mbouyer/domotique/README.md

# domotique
gestion du chauffage et aération d'une habitation
