mbouyer/domotique/hardware/CAD/support-controle.FCStd

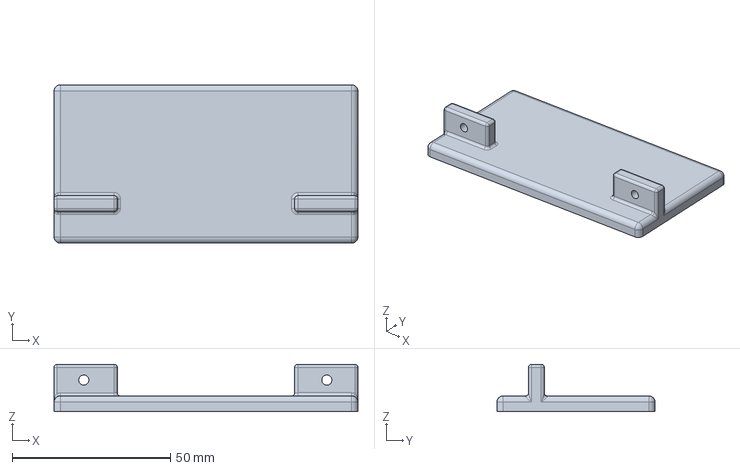
[picture p1: CAD file, 2026-06-16]
hardware/CAD/support-controle.FCStd
96.0 x 50.0 x 15.0 mm
