mbouyer/domotique/hardware/energie/CAD/1597DIN6MDH53.dxf

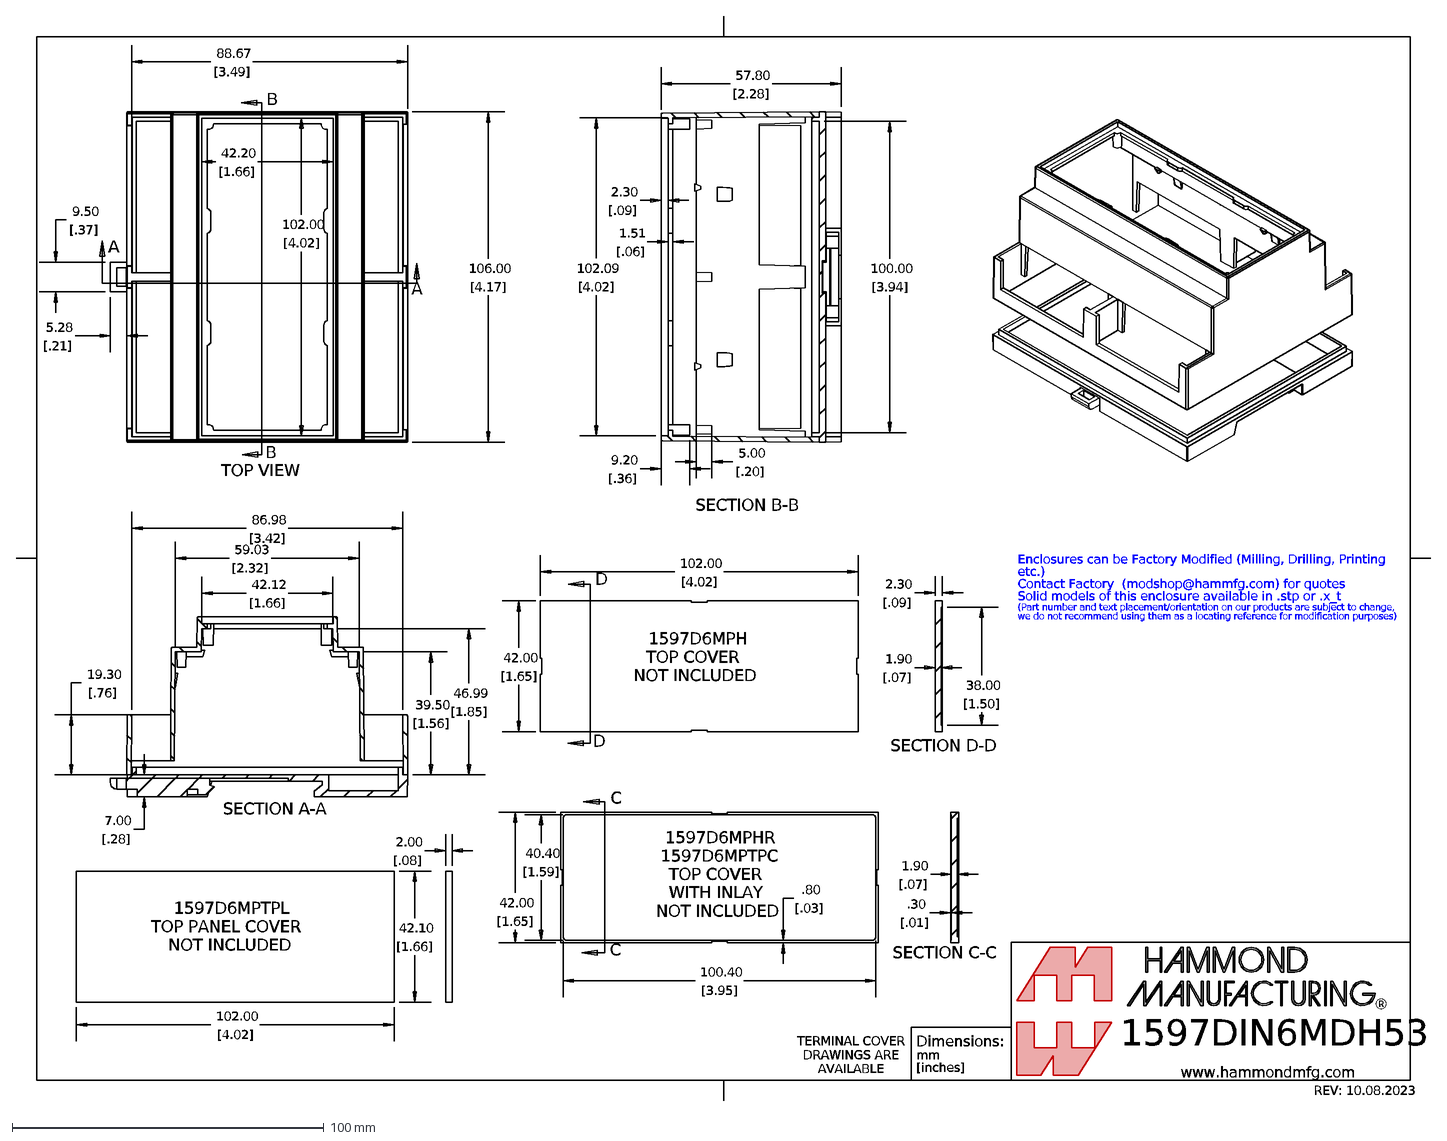
[picture p2: CAD file, 2024-11-22]
hardware/energie/CAD/1597DIN6MDH53.dxf
1597DIN6MDH53
REV: 10.08.2023
Dimensions: mm [inches]
www.hammondmfg.com
Enclosures can be Factory Modified (Milling, Drilling, Printing etc.) Contact Factory (modshop@hammfg.com) for quotes Solid models of this enclosure available i
®
TOP VIEW
A
SECTION A-A
B
SECTION B-B
1597D6MPH
TOP COVER
NOT INCLUDED
1597D6MPHR
1597D6MPTPC
WITH INLAY
102.00
[4.02]
42.00
[1.65]
40.40
[1.59]
100.40
[3.95]
C
SECTION C-C
.30
[.01]
D
SECTION D-D
1.90
[.07]
38.00
[1.50]
2.30
[.09]
.80
[.03]
9.50
[.37]
42.12
[1.66]
59.03
[2.32]
86.98
[3.42]
39.50
[1.56]
19.30
[.76]
88.67
[3.49]
57.80
[2.28]
106.00
[4.17]
42.20
1.51
[.06]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
