mbouyer/domotique/hardware/support-SEN0331/base.stl

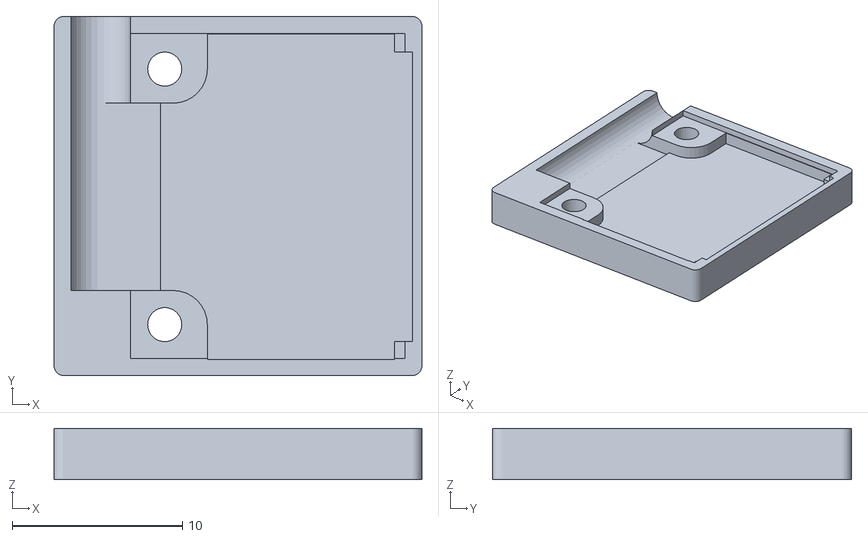
[picture p3: CAD file, 2025-10-03]
hardware/support-SEN0331/base.stl
21.6 x 21.1 x 3.00
