mbouyer/domotique/hardware/ventil/CAD/trappes.dxf

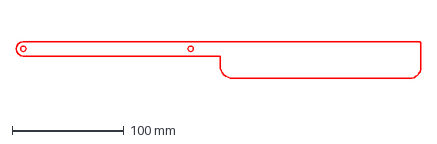
[picture p4: CAD file, 2025-04-16]
hardware/ventil/CAD/trappes.dxf
363.0 x 33.0 mm
