mbouyer/domotique/hardware/CAD/support-SEN0385.stl

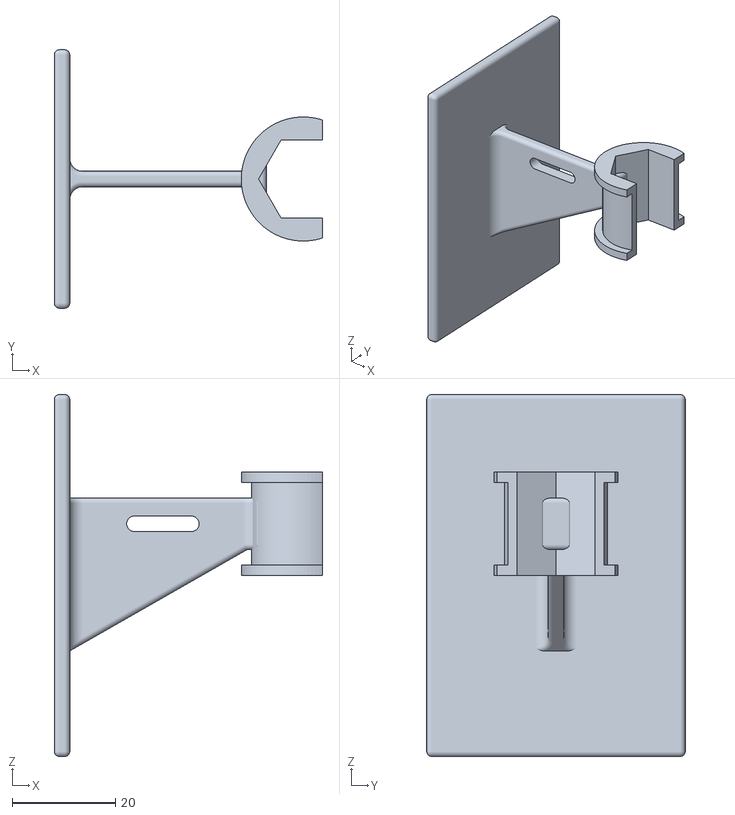
[picture p5: CAD file, 2025-04-15]
hardware/CAD/support-SEN0385.stl
51.9 x 50.0 x 70.0
