mbouyer/domotique/hardware/support-SEN0331/box.stl

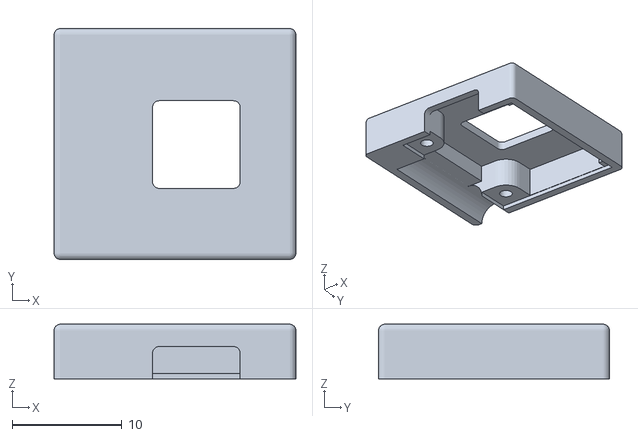
[picture p6: CAD file, 2025-10-03]
hardware/support-SEN0331/box.stl
22.1 x 21.1 x 5.00
