mbouyer/domotique/hardware/ventil/CAD/reglage.dxf

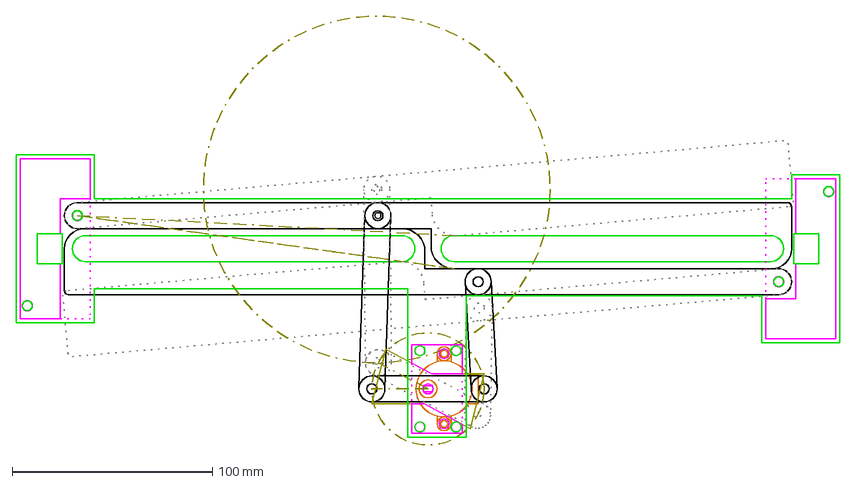
[picture p7: CAD file, 2025-04-16]
hardware/ventil/CAD/reglage.dxf
411.0 x 214.0 mm
