mbouyer/domotique/hardware/support-SEN0331/board.dxf

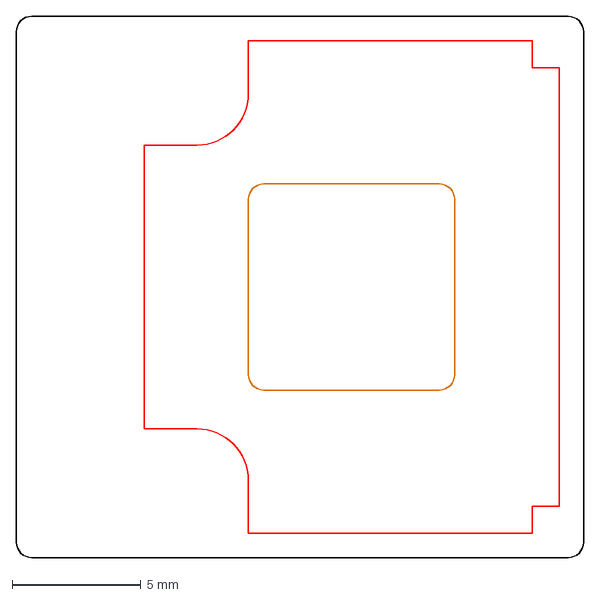
[picture p8: CAD file, 2025-10-03]
hardware/support-SEN0331/board.dxf
22.0 x 21.0 mm
