mbouyer/domotique/hardware/ventil/CAD/gabari.dxf

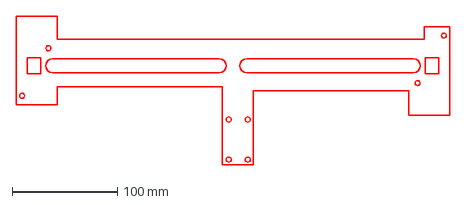
[picture p9: CAD file, 2025-04-16]
hardware/ventil/CAD/gabari.dxf
411.0 x 141.0 mm
