mbouyer/domotique/hardware/ventil/CAD/bielle-2.dxf

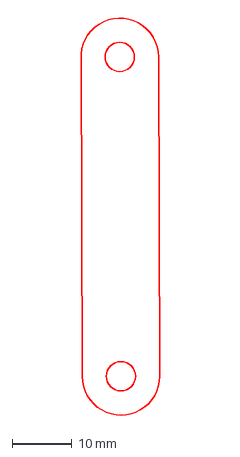
[picture p10: CAD file, 2025-04-16]
hardware/ventil/CAD/bielle-2.dxf
13.3 x 67.2 mm
