mbouyer/domotique/hardware/ventil/CAD/bielle-1.dxf

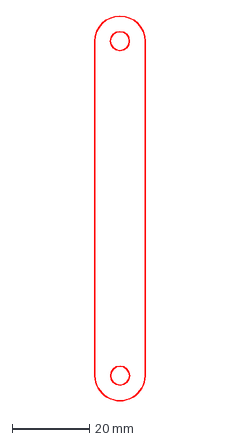
[picture p11: CAD file, 2025-04-16]
hardware/ventil/CAD/bielle-1.dxf
13.0 x 99.8 mm
