mbouyer/domotique/hardware/ventil/CAD/bielles.dxf

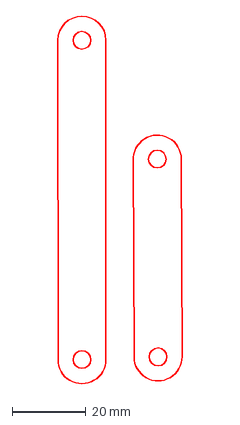
[picture p12: CAD file, 2025-04-15]
hardware/ventil/CAD/bielles.dxf
33.6 x 99.8 mm
