mbouyer/domotique/hardware/ventil/CAD/levier.dxf

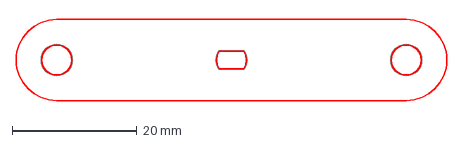
[picture p13: CAD file, 2025-04-15]
hardware/ventil/CAD/levier.dxf
69.0 x 13.0 mm
