mbouyer/domotique/hardware/ventil/CAD/passage_bielles.dxf

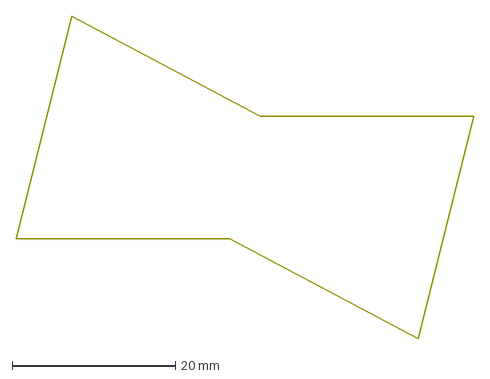
[picture p14: CAD file, 2025-04-11]
hardware/ventil/CAD/passage_bielles.dxf
56.0 x 39.5 mm
