mbouyer/domotique/hardware/support-SEN0331/params.scad

x_board=16.1;
y_board=19.1;
z_board=1;
d_cable=3.5;
ep_box=1;

x_box=x_board+d_cable+ep_box*2;
y_box=y_board+ep_box*2;
z_box=8;
z_cover=5;
z_base=z_box-z_cover;
