mbouyer/domotique/(list of files, cad)

Other CAD files:
hardware/ventil/CAD/axes_tete.scad
hardware/CAD/support-controle.dxf
