mbouyer/domotique/hardware/controle/controle.kicad_pcb

## KiCad design hardware/controle/controle.kicad_pcb (2026-06-11)

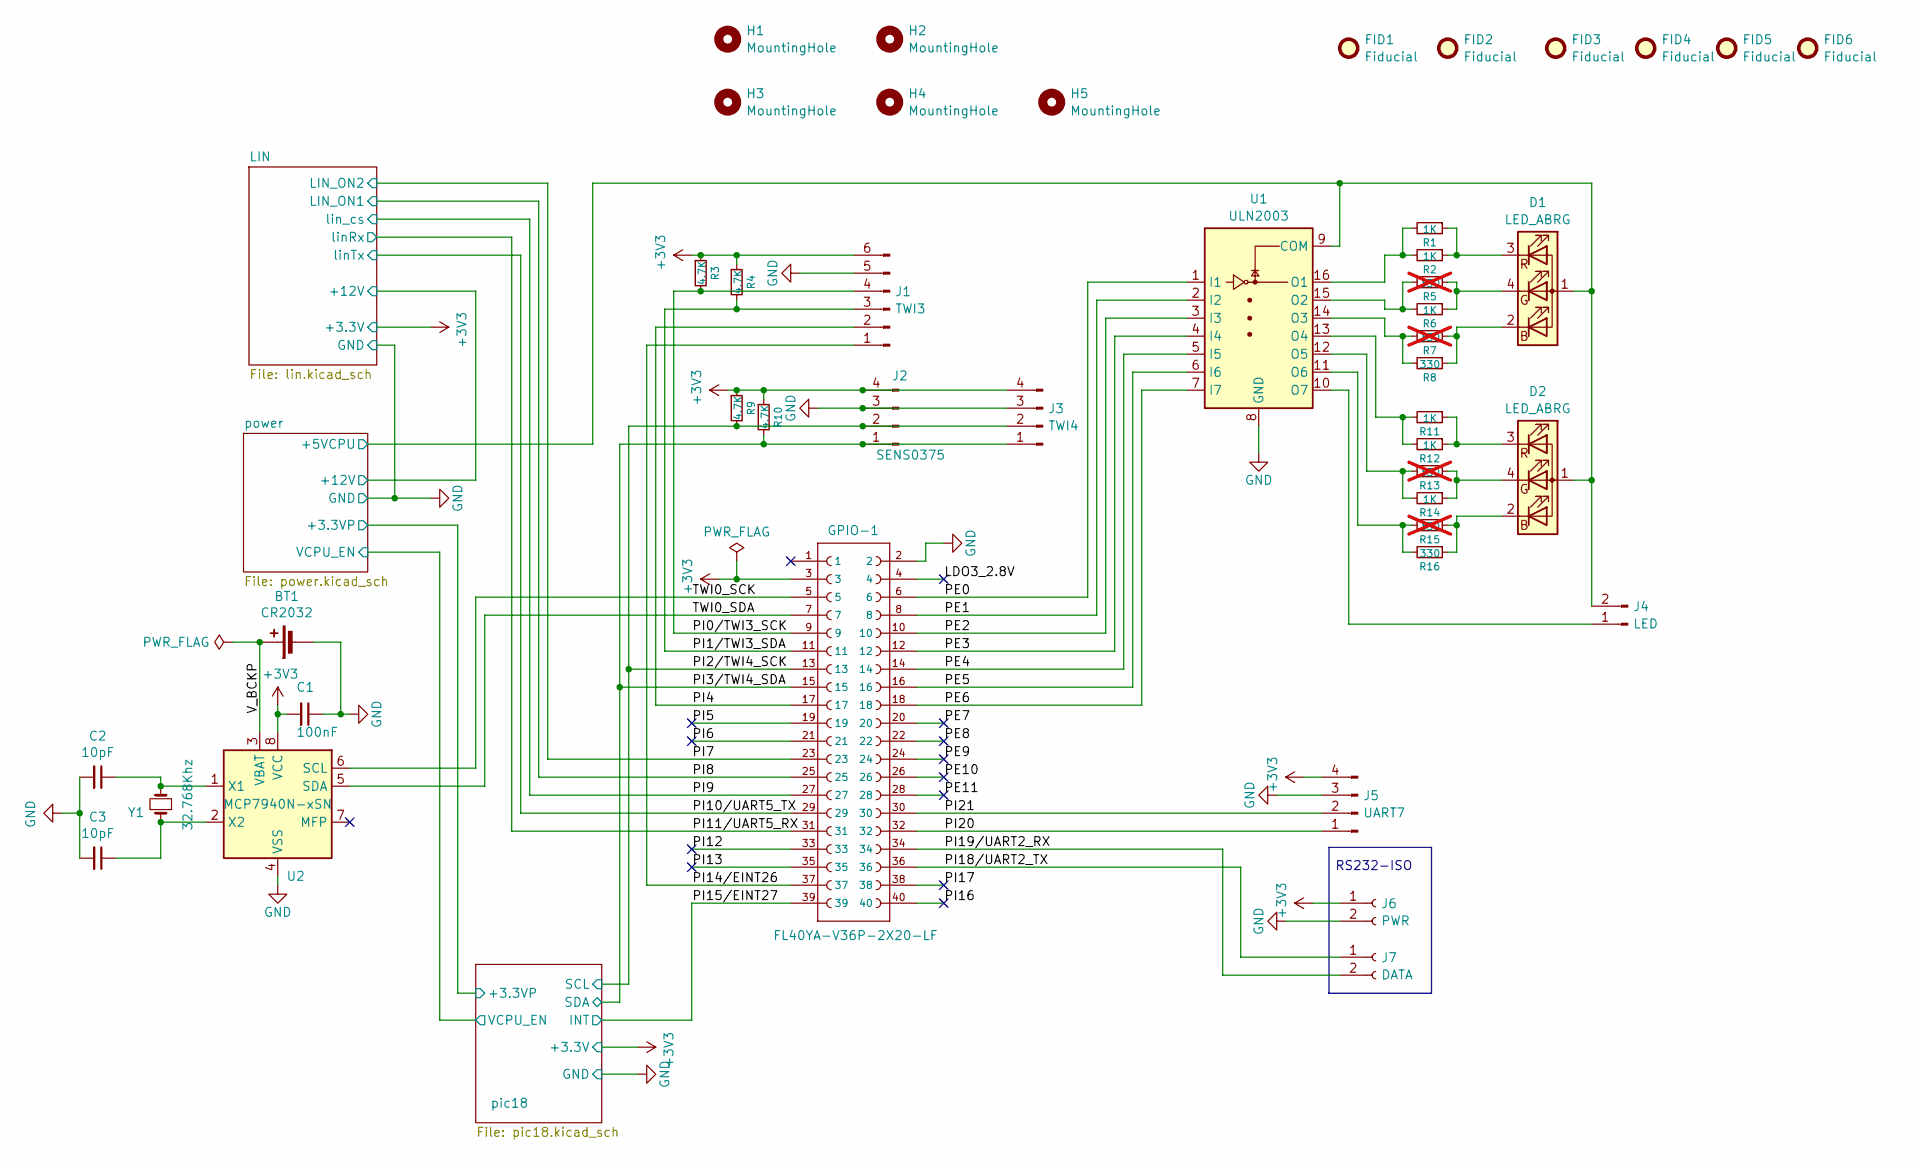
[picture p15: schematic controle.kicad_sch]

Parts:
BT1: CR2032; 1066
C1: 100nF; C_0603_1608Metric_Pad1.08x0.95mm_HandSolder
C2, C3: 10pF; C_0603_1608Metric_Pad1.08x0.95mm_HandSolder
D1, D2: LED_ABRG; LED MP001251
FID1, FID2, FID3, FID4, FID5, FID6: Fiducial; Fiducial_1mm_Mask2mm
GPIO-1: FL40YA-V36P-2X20-LF; A10_OLIMEXINO_LIME_SHIELD_1-YA-V36P-2X20-LF
H1, H2, H3, H4, H5: MountingHole; MountingHole_3.2mm_M3
J1: TWI3; PinHeader_1x06_P2.54mm_Vertical
J2: SENS0375; PinHeader_1x04_P2.54mm_Vertical
J3: TWI4; PinHeader_1x04_P2.54mm_Vertical
J4: LED; PinHeader_1x02_P2.54mm_Vertical
J5: UART7; PinHeader_1x04_P2.54mm_Vertical
J6: PWR; PinSocket_1x02_P2.54mm_Vertical
J7: DATA; PinSocket_1x02_P2.54mm_Vertical
R1, R2, R6, R11, R12, R14: 1K; R_0805_2012Metric_Pad1.20x1.40mm_HandSolder
R3, R4, R9, R10: 4.7K; R_0805_2012Metric_Pad1.20x1.40mm_HandSolder
R5, R7, R13, R15: 330; R_0805_2012Metric_Pad1.20x1.40mm_HandSolder; not fitted
R8, R16: 330; R_0805_2012Metric_Pad1.20x1.40mm_HandSolder
U1: ULN2003; SOIC-16_3.9x9.9mm_P1.27mm
U2: MCP7940N-xSN; SOIC-8_3.9x4.9mm_P1.27mm
Y1: 32.768Khz; CMR200T

Connections:
+3V3: C1.2, GPIO-1.3, J1.6, J2.4, J3.4, J5.4, J6.1, R3.1, R4.1, R9.1, R10.1, U2.8 (VCC); also elsewhere on the board
/LDO3_2.8V: GPIO-1.4
/PE0: GPIO-1.6, U1.1 (I1)
/PE1: GPIO-1.8, U1.2 (I2)
/PE2: GPIO-1.10, U1.3 (I3)
/PE3: GPIO-1.12, U1.4 (I4)
/PE4: GPIO-1.14, U1.5 (I5)
/PE5: GPIO-1.16, U1.6 (I6)
/PE6: GPIO-1.18, U1.7 (I7)
/PE7: GPIO-1.20
/PE8: GPIO-1.22
/PE9: GPIO-1.24
/PE10: GPIO-1.26
/PE11: GPIO-1.28
/PI0/TWI3_SCK: GPIO-1.9, J1.4, R3.2
/PI1/TWI3_SDA: GPIO-1.11, J1.3, R4.2
/PI2/TWI4_SCK: GPIO-1.13, J2.2, J3.2, R9.2; also elsewhere on the board
/PI3/TWI4_SDA: GPIO-1.15, J2.1, J3.1, R10.2; also elsewhere on the board
/PI4: GPIO-1.17, J1.2
/PI5: GPIO-1.19
/PI6: GPIO-1.21
/PI7: GPIO-1.23; also elsewhere on the board
/PI8: GPIO-1.25; also elsewhere on the board
/PI9: GPIO-1.27; also elsewhere on the board
/PI10/UART5_TX: GPIO-1.29; also elsewhere on the board
/PI11/UART5_RX: GPIO-1.31; also elsewhere on the board
/PI12: GPIO-1.33
/PI13: GPIO-1.35
/PI14/EINT26: GPIO-1.37, J1.1
/PI15/EINT27: GPIO-1.39; also elsewhere on the board
/PI16: GPIO-1.40
/PI17: GPIO-1.38
/PI18/UART2_TX: GPIO-1.36, J7.1
/PI19/UART2_RX: GPIO-1.34, J7.2
/PI20: GPIO-1.32, J5.1
/PI21: GPIO-1.30, J5.2
/TWI0_SCK: GPIO-1.5, U2.6 (SCL)
/TWI0_SDA: GPIO-1.7, U2.5 (SDA)
/V_BCKP: BT1.1 (+), U2.3 (VBAT)
/power/+5VCPU: D1.1 (A), D2.1 (A), J4.2, U1.9 (COM); also elsewhere on the board
GND: BT1.2 (-), C1.1, C2.2, C3.2, GPIO-1.2, J1.5, J2.3, J3.3, J5.3, J6.2, U1.8 (GND), U2.4 (VSS); also elsewhere on the board
unnamed: D1.2 (BK), R7.1, R8.1
unnamed: D1.4 (GK), R5.1, R6.1
unnamed: D1.3 (RK), R1.1, R2.1
unnamed: D2.2 (BK), R15.1, R16.1
unnamed: D2.4 (GK), R13.1, R14.1
unnamed: D2.3 (RK), R11.1, R12.1
unnamed: J4.1, U1.10 (O7)
unnamed: R1.2, R2.2, U1.16 (O1)
unnamed: R5.2, R6.2, U1.15 (O2)
unnamed: R7.2, R8.2, U1.14 (O3)
unnamed: R11.2, R12.2, U1.13 (O4)
unnamed: R13.2, R14.2, U1.12 (O5)
unnamed: R15.2, R16.2, U1.11 (O6)
unnamed: C2.1, U2.1 (X1), Y1.2
unnamed: C3.1, U2.2 (X2), Y1.1

Notes on the sheet:
RS232-ISO

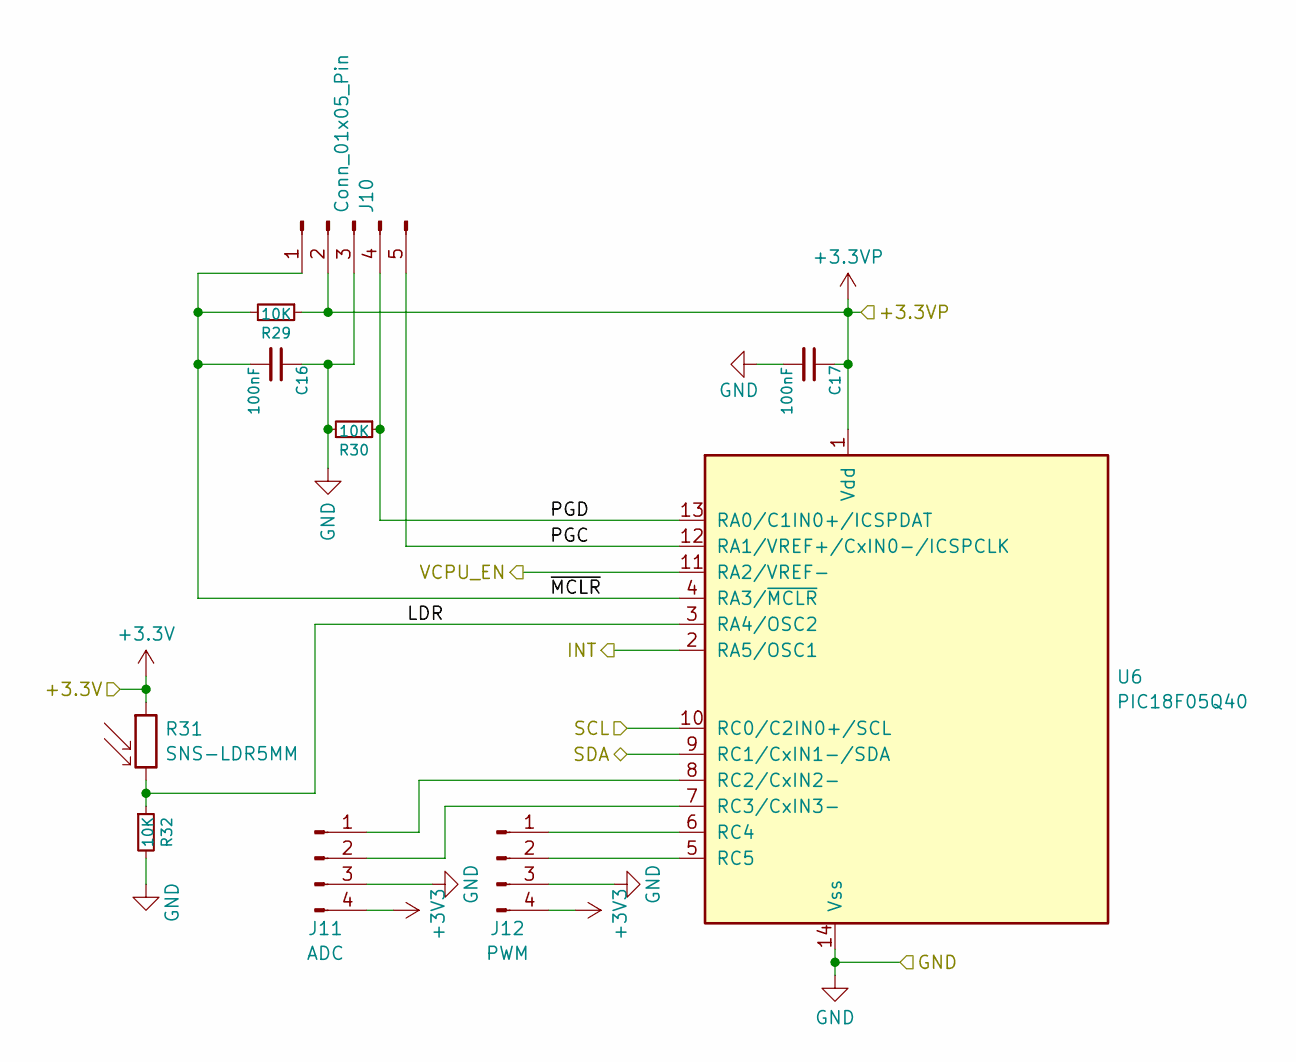
[picture p16: schematic pic18.kicad_sch]

Parts:
C16, C17: 100nF; C_0603_1608Metric_Pad1.08x0.95mm_HandSolder
J10: Conn_01x05_Pin; PinHeader_1x05_P2.54mm_Horizontal
J11: ADC; PinHeader_1x04_P2.54mm_Vertical
J12: PWM; PinHeader_1x04_P2.54mm_Vertical
R29, R30, R32: 10K; R_0805_2012Metric_Pad1.20x1.40mm_HandSolder
R31: SNS-LDR5MM; R_LDR_5.0x4.1mm_P3mm_Vertical
U6: PIC18F05Q40; SOIC-14_3.9x8.7mm_P1.27mm

Connections:
+3.3VP: C17.1, J10.2, R29.1, U6.1 (Vdd); also elsewhere on the board
+3V3: J11.4, J12.4, R31.1; also elsewhere on the board
/PI2/TWI4_SCK: U6.10 (RC0/C2IN0+/SCL); also elsewhere on the board
/PI3/TWI4_SDA: U6.9 (RC1/CxIN1-/SDA); also elsewhere on the board
/PI15/EINT27: U6.2 (RA5/OSC1); also elsewhere on the board
/pic18/LDR: R31.2, R32.1, U6.3 (RA4/OSC2)
/pic18/PGC: J10.5, U6.12 (RA1/VREF+/CxIN0-/ICSPCLK)
/pic18/PGD: J10.4, R30.1, U6.13 (RA0/C1IN0+/ICSPDAT)
/pic18/VCPU_EN: U6.11 (RA2/VREF-); also elsewhere on the board
/pic18/~MCLR: C16.2, J10.1, R29.2, U6.4 (RA3/~MCLR)
GND: C16.1, C17.2, J10.3, J11.3, J12.3, R30.2, R32.2, U6.14 (Vss); also elsewhere on the board
unnamed: J11.1, U6.8 (RC2/CxIN2-)
unnamed: J11.2, U6.7 (RC3/CxIN3-)
unnamed: J12.1, U6.6 (RC4)
unnamed: J12.2, U6.5 (RC5)

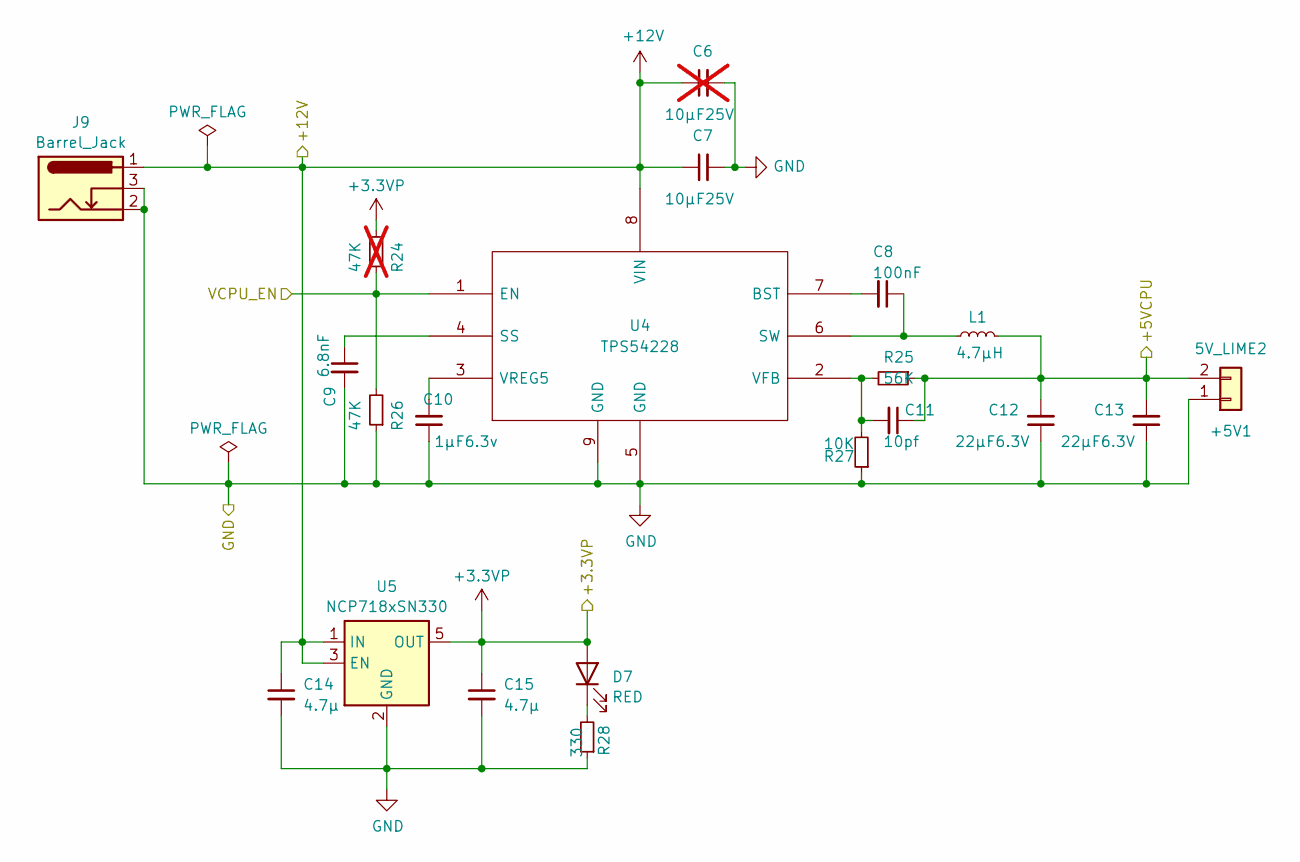
[picture p17: schematic power.kicad_sch]

Parts:
+5V1: 5V_LIME2; MC24356
C6: 10µF25V; C_1210_3225Metric_Pad1.33x2.70mm_HandSolder; not fitted
C7: 10µF25V; C_1210_3225Metric_Pad1.33x2.70mm_HandSolder
C8: 100nF; C_0603_1608Metric_Pad1.08x0.95mm_HandSolder
C9: 6.8nF; C_0603_1608Metric_Pad1.08x0.95mm_HandSolder
C10: 1µF6.3v; C_0603_1608Metric_Pad1.08x0.95mm_HandSolder
C11: 10pf; C_0603_1608Metric_Pad1.08x0.95mm_HandSolder
C12, C13: 22µF6.3V; C_1210_3225Metric_Pad1.33x2.70mm_HandSolder
C14, C15: 4.7µ; C_0805_2012Metric_Pad1.18x1.45mm_HandSolder
D7: RED; LED_0805_2012Metric
J9: Barrel_Jack; BarrelJack_Wuerth_6941xx301002
L1: 4.7µH; L_TT_7.3x6.8
R24: 47K; R_0805_2012Metric_Pad1.20x1.40mm_HandSolder; not fitted
R25: 56K; R_0805_2012Metric_Pad1.20x1.40mm_HandSolder
R26: 47K; R_0805_2012Metric_Pad1.20x1.40mm_HandSolder
R27: 10K; R_0805_2012Metric_Pad1.20x1.40mm_HandSolder
R28: 330; R_0805_2012Metric_Pad1.20x1.40mm_HandSolder
U4: TPS54228; SOIC-8-1EP_3.9x4.9mm_P1.27mm_EP2.41x3.3mm
U5: NCP718xSN330; SOT-23-5

Connections:
+3.3VP: C15.1, D7.2 (A), R24.2, U5.5 (OUT); also elsewhere on the board
+12V: C6.1, C7.1, C14.1, J9.1, U4.8 (VIN), U5.1 (IN), U5.3 (EN); also elsewhere on the board
/pic18/VCPU_EN: R24.1, R26.2, U4.1 (EN); also elsewhere on the board
/power/+5VCPU: +5V1.2, C11.1, C12.2, C13.2, L1.2, R25.1; also elsewhere on the board
GND: +5V1.1, C6.2, C7.2, C9.2, C10.1, C12.1, C13.1, C14.2, C15.2, J9.2, J9.3, R26.1, R27.1, R28.1, U4.5 (GND), U4.9 (GND), U5.2 (GND); also elsewhere on the board
unnamed: D7.1 (K), R28.2
unnamed: C8.2, U4.7 (BST)
unnamed: C9.1, U4.4 (SS)
unnamed: C8.1, L1.1, U4.6 (SW)
unnamed: C11.2, R25.2, R27.2, U4.2 (VFB)
unnamed: C10.2, U4.3 (VREG5)

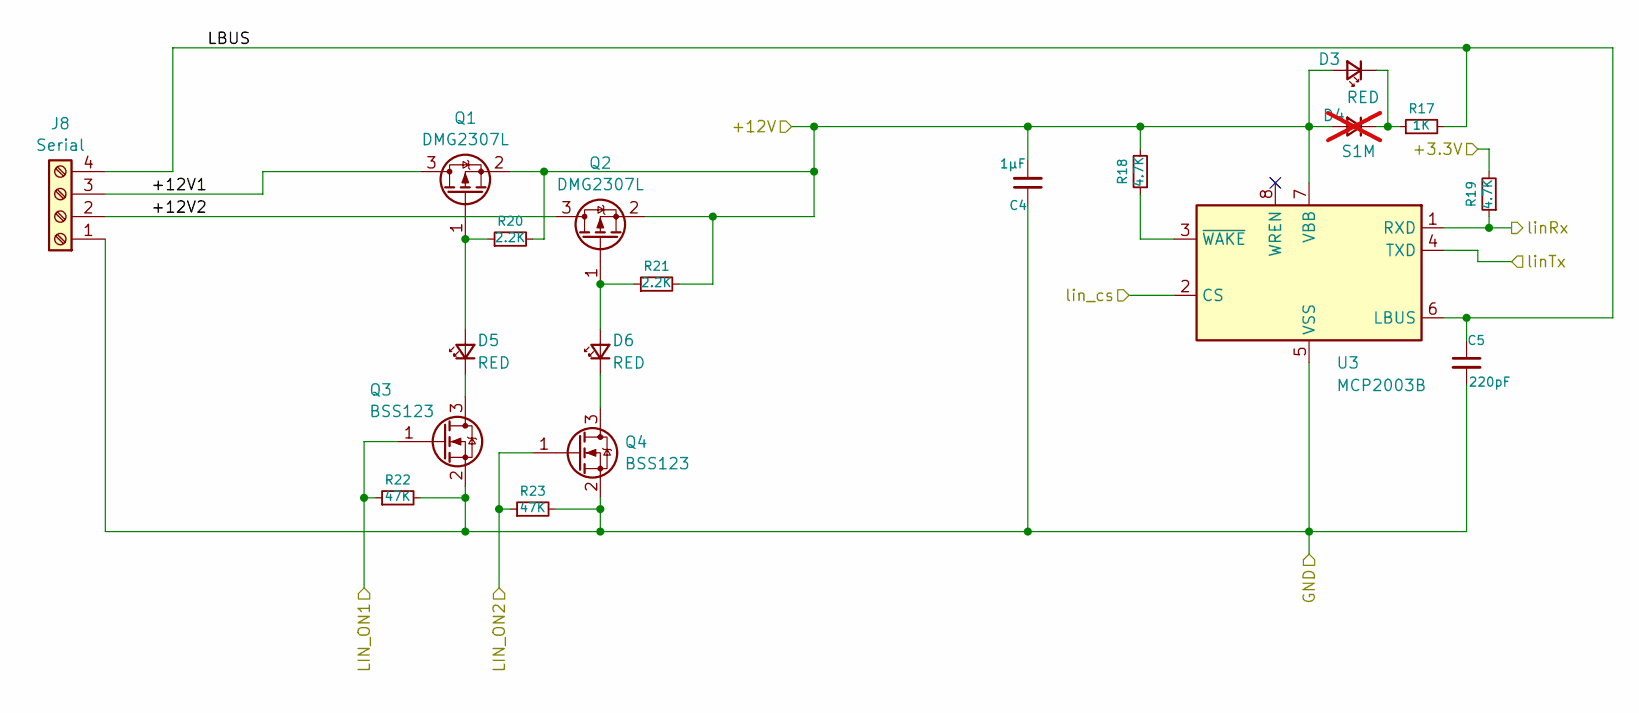
[picture p18: schematic lin.kicad_sch]

Parts:
C4: 1µF; C_0805_2012Metric_Pad1.18x1.45mm_HandSolder
C5: 220pF; C_0603_1608Metric_Pad1.08x0.95mm_HandSolder
D3, D5, D6: RED; LED_0603_1608Metric_Pad1.05x0.95mm_HandSolder
D4: S1M; D_SMA; not fitted
J8: Serial; PhoenixContact_MCV_1,5_4-G-3.5_1x04_P3.50mm_Vertical
Q1, Q2: DMG2307L; SOT-23
Q3, Q4: BSS123; SOT-23
R17: 1K; R_0805_2012Metric_Pad1.20x1.40mm_HandSolder
R18, R19: 4.7K; R_0805_2012Metric_Pad1.20x1.40mm_HandSolder
R20, R21: 2.2K; R_0805_2012Metric_Pad1.20x1.40mm_HandSolder
R22, R23: 47K; R_0805_2012Metric_Pad1.20x1.40mm_HandSolder
U3: MCP2003B; SOIC-8_3.9x4.9mm_P1.27mm

Connections:
+3V3: R19.2; also elsewhere on the board
+12V: C4.2, D3.2 (A), D4.2 (A), Q1.2 (S), Q2.2 (S), R18.2, R20.2, R21.2, U3.7 (VBB); also elsewhere on the board
/LIN/+12V1: J8.3, Q1.3 (D)
/LIN/+12V2: J8.2, Q2.3 (D)
/LIN/LBUS: C5.1, J8.4, R17.2, U3.6 (LBUS)
/PI7: Q4.1 (G), R23.1; also elsewhere on the board
/PI8: Q3.1 (G), R22.1; also elsewhere on the board
/PI9: U3.2 (CS); also elsewhere on the board
/PI10/UART5_TX: U3.4 (TXD); also elsewhere on the board
/PI11/UART5_RX: R19.1, U3.1 (RXD); also elsewhere on the board
GND: C4.1, C5.2, J8.1, Q3.2 (S), Q4.2 (S), R22.2, R23.2, U3.5 (VSS); also elsewhere on the board
unnamed: D3.1 (K), D4.1 (K), R17.1
unnamed: D5.2 (A), Q1.1 (G), R20.1
unnamed: D5.1 (K), Q3.3 (D)
unnamed: D6.2 (A), Q2.1 (G), R21.1
unnamed: D6.1 (K), Q4.3 (D)
unnamed: R18.1, U3.3 (~WAKE)

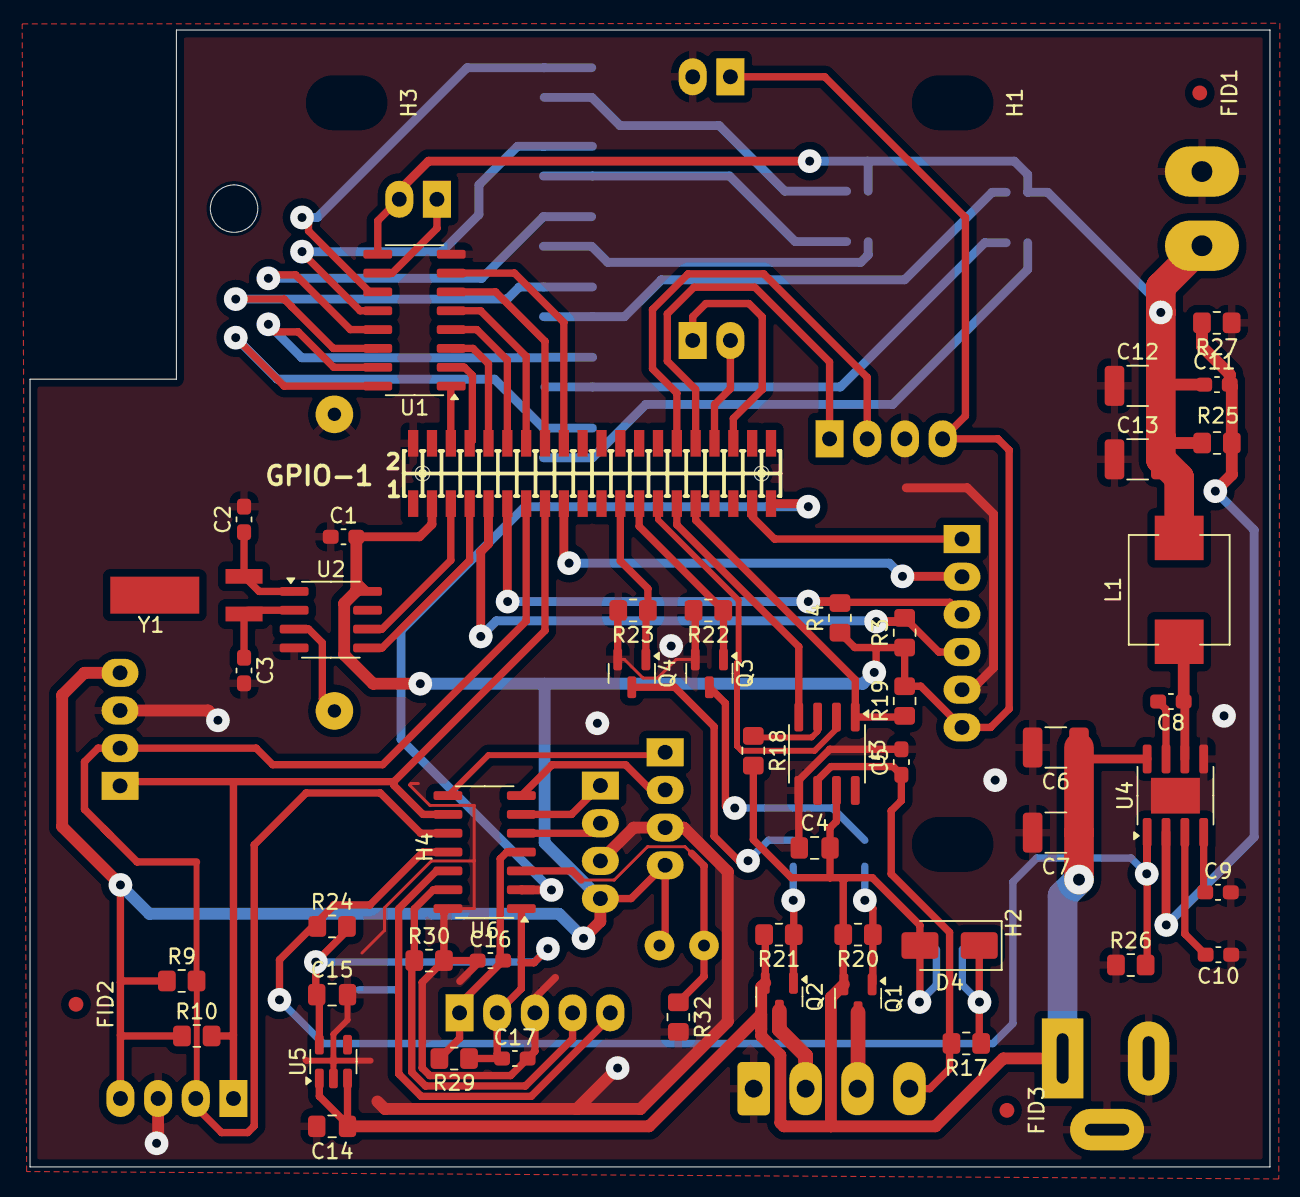
[picture p19: board controle.kicad_pcb from above]

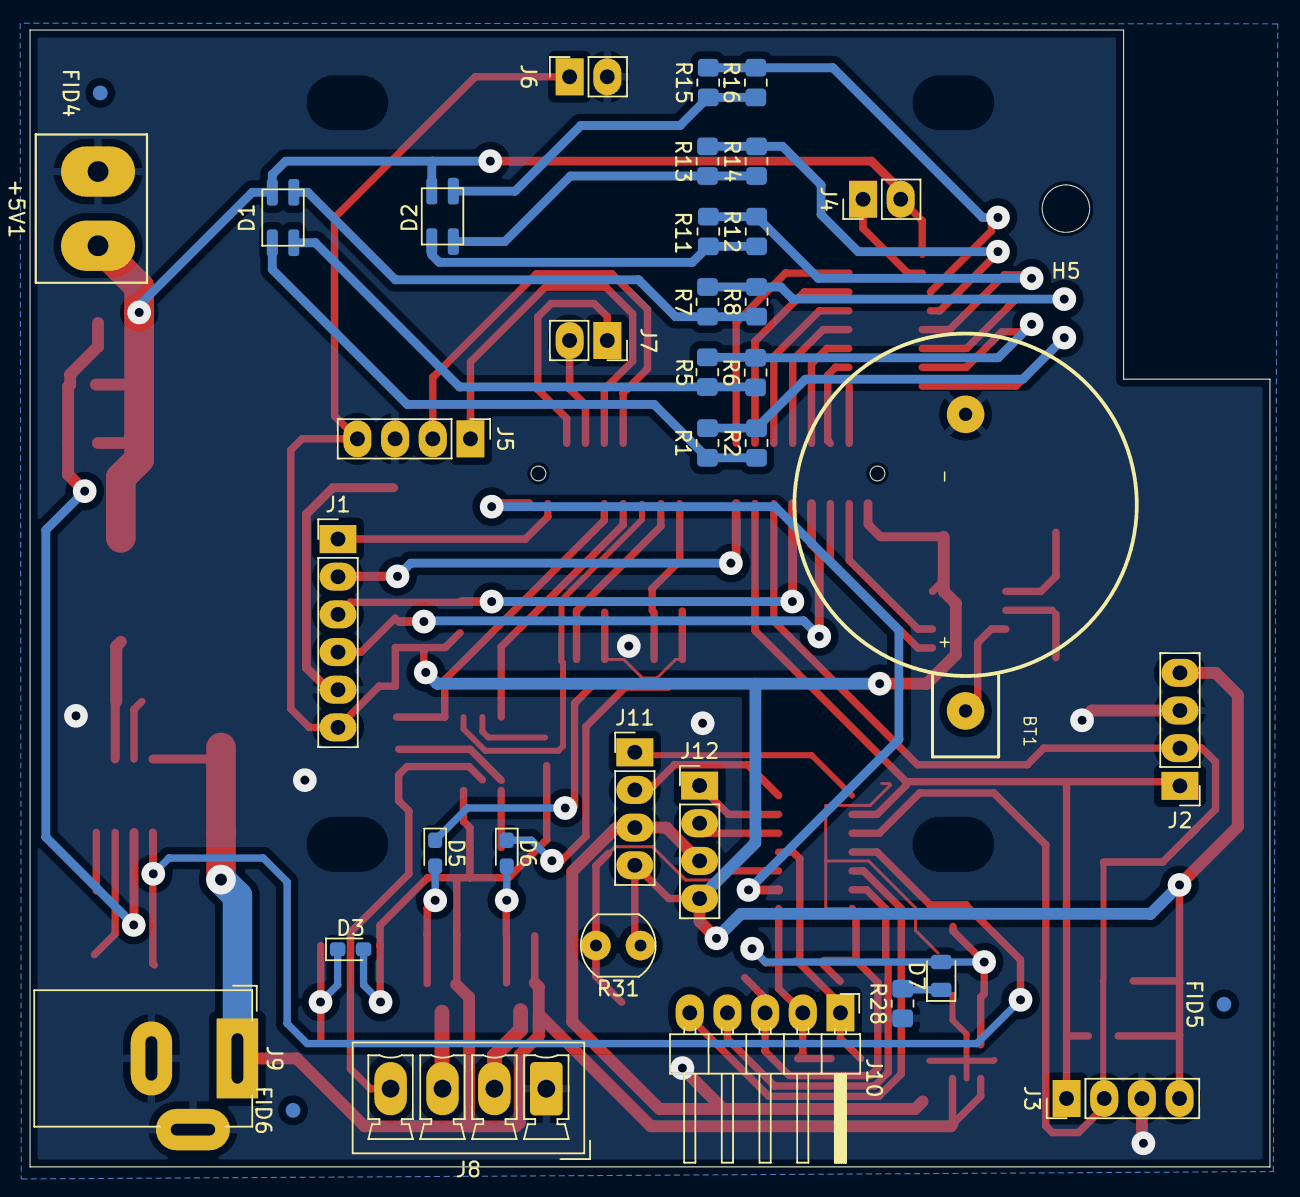
[picture p20: board controle.kicad_pcb from below]

Board: 2 copper layers, 83.6 x 76.7 mm, 94 parts (38 on the bottom side), 70 nets.
