mbouyer/domotique/hardware/sht31-break/sht31-break.kicad_pcb

## KiCad design hardware/sht31-break/sht31-break.kicad_pcb (2025-05-09)

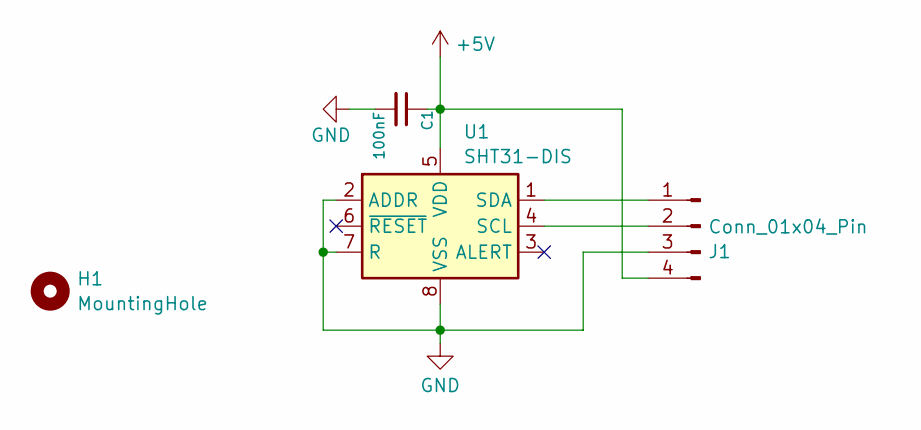
[picture p21: schematic sht31-break.kicad_sch]

Parts:
C1: 100nF; C_0603_1608Metric_Pad1.08x0.95mm_HandSolder
H1: MountingHole; MountingHole_3.2mm_M3
J1: Conn_01x04_Pin; SolderWire-0.1sqmm_1x04_P3.6mm_D0.4mm_OD1mm_Relief
U1: SHT31-DIS; Sensirion_DFN-8-1EP_2.5x2.5mm_P0.5mm_EP1.1x1.7mm

Connections:
+5V: C1.1, J1.4, U1.5 (VDD)
GND: C1.2, J1.3, U1.2 (ADDR), U1.7 (R), U1.8 (VSS), U1.9 (VSS)
unnamed: J1.1, U1.1 (SDA)
unnamed: J1.2, U1.4 (SCL)

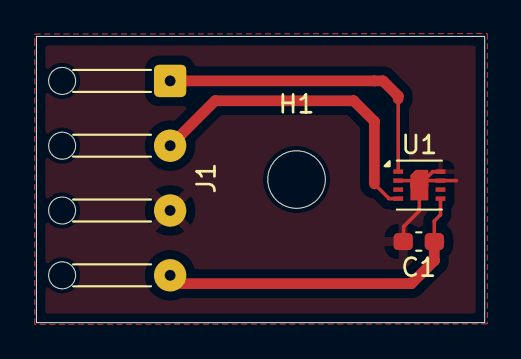
[picture p22: board sht31-break.kicad_pcb from above]

Board: 2 copper layers, 24.9 x 15.9 mm, 4 parts (0 on the bottom side), 4 nets.
