mbouyer/domotique/hardware/ventil/ventil.kicad_pcb

## KiCad design hardware/ventil/ventil.kicad_pcb (2025-04-18)

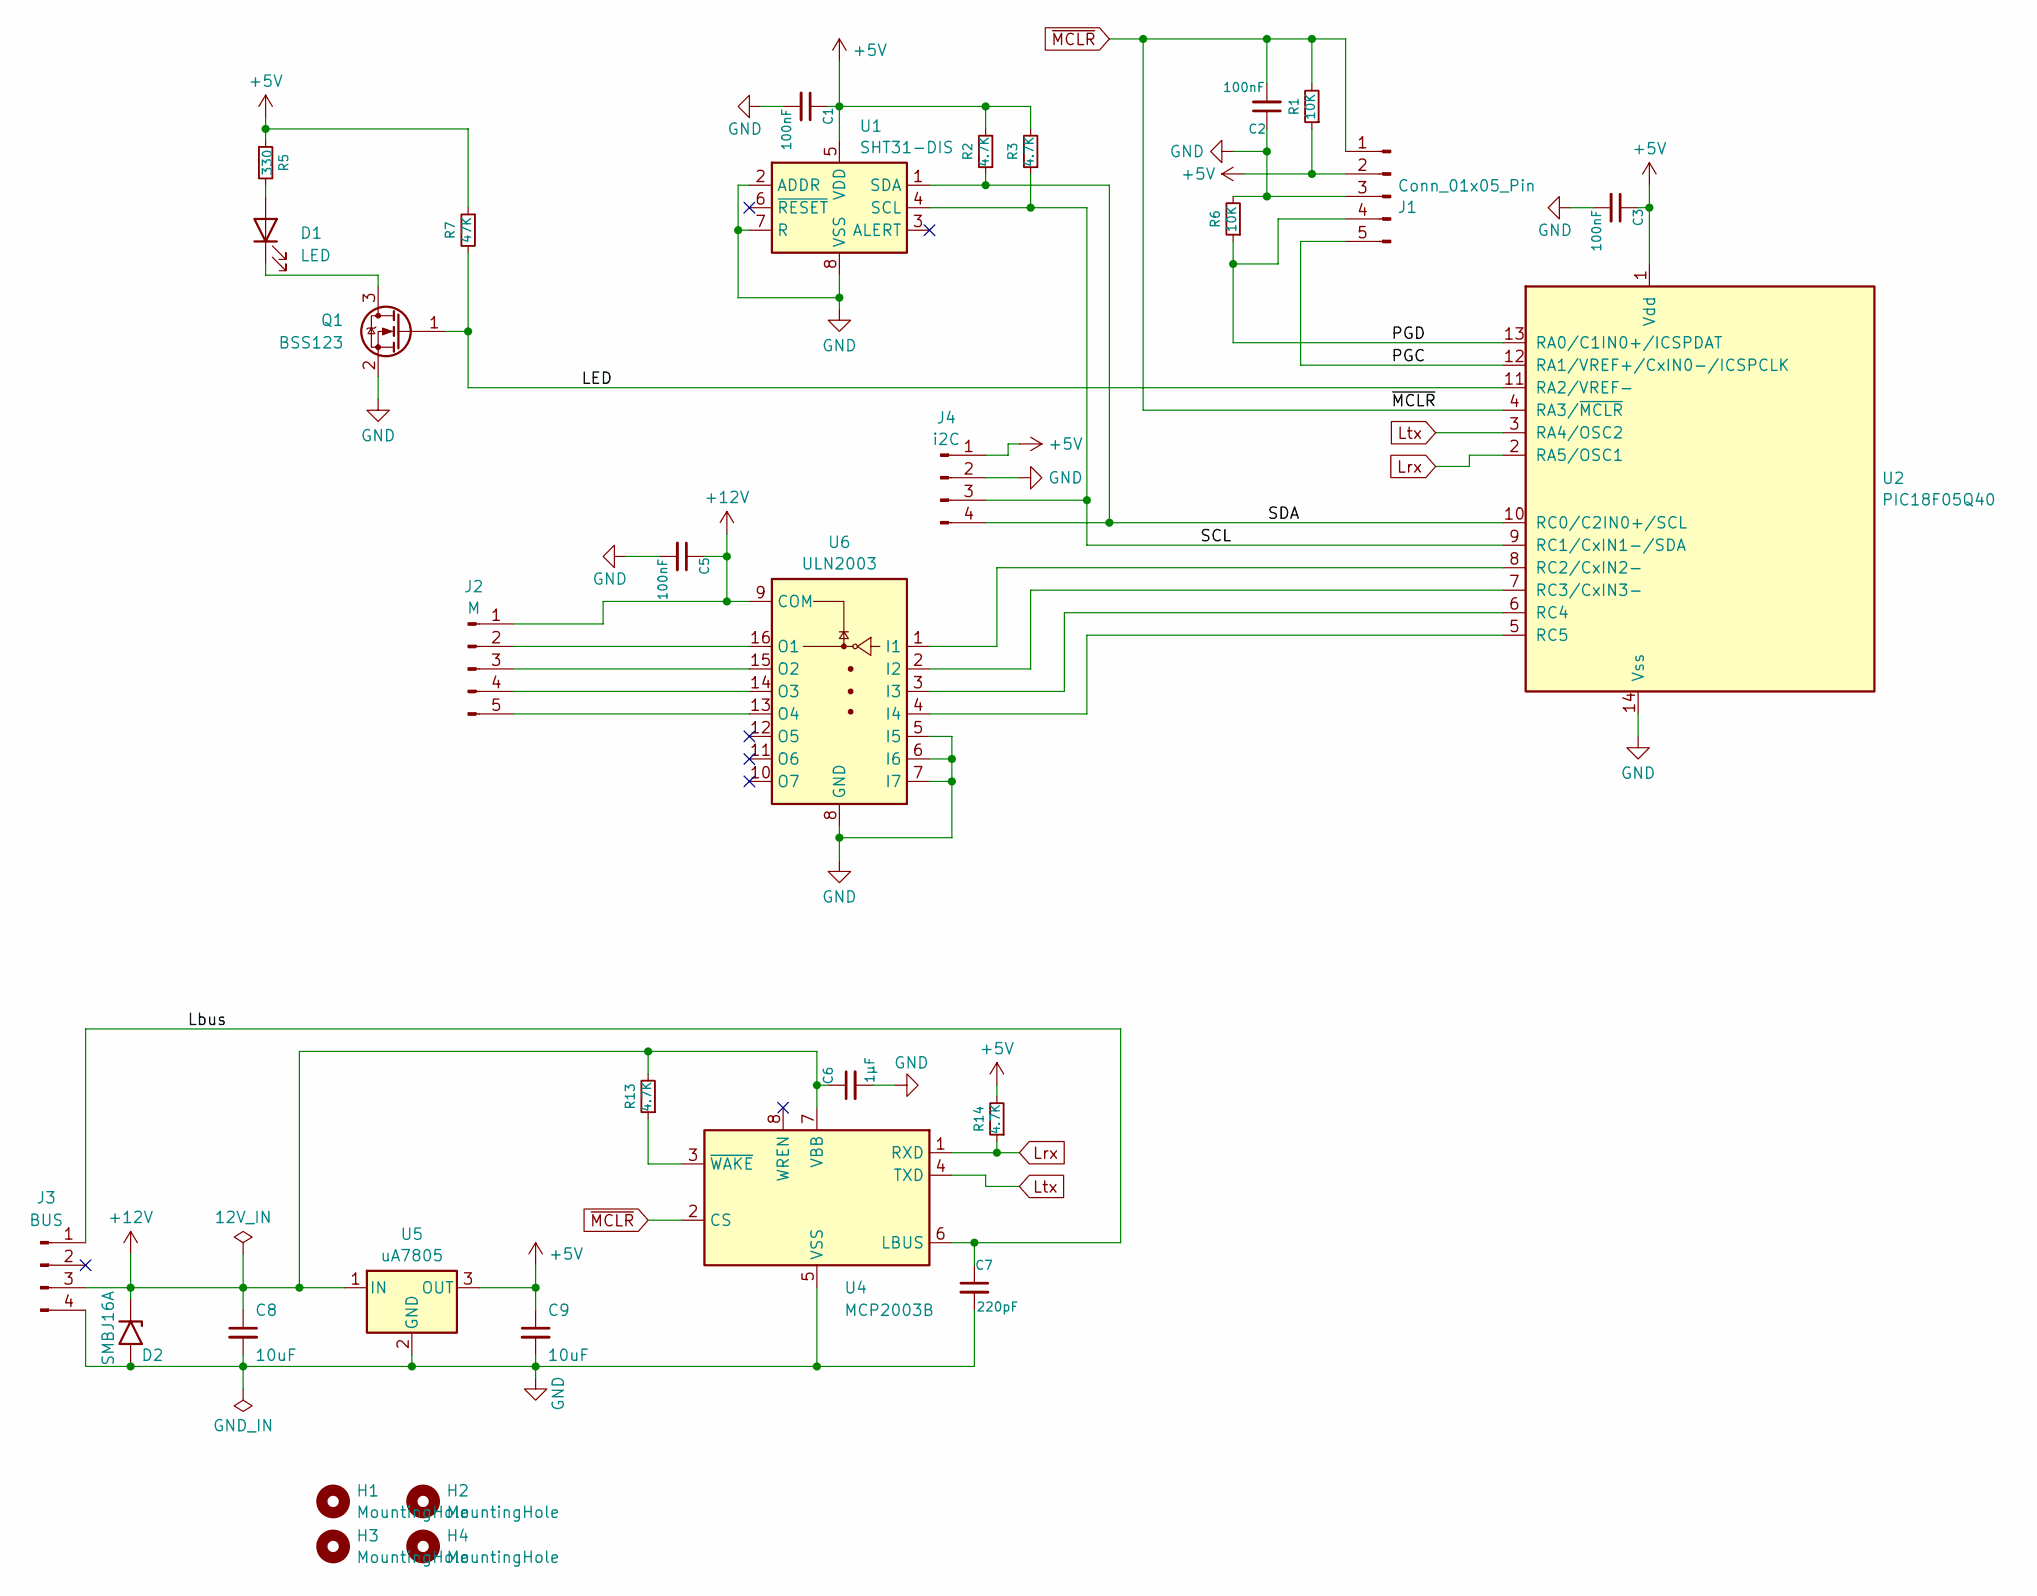
[picture p23: schematic ventil.kicad_sch]

Parts:
C1, C2, C3, C5: 100nF; C_0603_1608Metric_Pad1.08x0.95mm_HandSolder
C6: 1µF; C_0805_2012Metric_Pad1.18x1.45mm_HandSolder
C7: 220pF; C_0603_1608Metric_Pad1.08x0.95mm_HandSolder
C8: 10uF; C_1210_3225Metric_Pad1.33x2.70mm_HandSolder
C9: 10uF; C_0805_2012Metric_Pad1.18x1.45mm_HandSolder
D1: LED; LED_0603_1608Metric_Pad1.05x0.95mm_HandSolder
D2: SMBJ16A; D_SMB_Handsoldering
H1, H2, H3, H4: MountingHole; MountingHole_3.2mm_M3
J1: Conn_01x05_Pin; Molex_Pico-SPOX-5-Vertical
J2: M; JST_XH_S5B-XH-A_1x05_P2.50mm_Horizontal
J3: BUS; Molex Pico-SPOX-4_90
J4: i2C; Molex Pico-SPOX-4_90
Q1: BSS123; SOT-23
R1, R6: 10K; R_0805_2012Metric_Pad1.20x1.40mm_HandSolder
R2, R3, R13, R14: 4.7K; R_0805_2012Metric_Pad1.20x1.40mm_HandSolder
R5: 330; R_0805_2012Metric_Pad1.20x1.40mm_HandSolder
R7: 47K; R_0805_2012Metric_Pad1.20x1.40mm_HandSolder
U1: SHT31-DIS; Sensirion_DFN-8-1EP_2.5x2.5mm_P0.5mm_EP1.1x1.7mm
U2: PIC18F05Q40; SOIC-14_3.9x8.7mm_P1.27mm
U4: MCP2003B; SOIC-8_3.9x4.9mm_P1.27mm
U5: uA7805; TO-252-3_TabPin2
U6: ULN2003; SOIC-16_3.9x9.9mm_P1.27mm

Connections:
+5V: C1.1, C3.1, C9.1, J1.2, J4.1, R1.1, R2.2, R3.2, R5.1, R7.1, R14.2, U1.5 (VDD), U2.1 (Vdd), U5.3 (OUT)
+12V: C5.1, C6.1, C8.1, D2.1 (A1), J2.1, J3.3, R13.2, U4.7 (VBB), U5.1 (IN), U6.9 (COM)
/LED: Q1.1 (G), R7.2, U2.11 (RA2/VREF-)
/Lbus: C7.1, J3.1, U4.6 (LBUS)
/PGC: J1.5, U2.12 (RA1/VREF+/CxIN0-/ICSPCLK)
/PGD: J1.4, R6.1, U2.13 (RA0/C1IN0+/ICSPDAT)
/SCL: J4.3, R3.1, U1.4 (SCL), U2.9 (RC1/CxIN1-/SDA)
/SDA: J4.4, R2.1, U1.1 (SDA), U2.10 (RC0/C2IN0+/SCL)
GND: C1.2, C2.1, C3.2, C5.2, C6.2, C7.2, C8.2, C9.2, D2.2 (A2), J1.3, J3.4, J4.2, Q1.2 (S), R6.2, U1.2 (ADDR), U1.7 (R), U1.8 (VSS), U1.9 (VSS), U2.14 (Vss), U4.5 (VSS), U5.2 (GND), U6.5 (I5), U6.6 (I6), U6.7 (I7), U6.8 (GND)
Lrx: R14.1, U2.2 (RA5/OSC1), U4.1 (RXD)
Ltx: U2.3 (RA4/OSC2), U4.4 (TXD)
unnamed: D1.2 (A), R5.2
unnamed: D1.1 (K), Q1.3 (D)
unnamed: J2.2, U6.16 (O1)
unnamed: J2.3, U6.15 (O2)
unnamed: J2.4, U6.14 (O3)
unnamed: J2.5, U6.13 (O4)
unnamed: U2.8 (RC2/CxIN2-), U6.1 (I1)
unnamed: U2.7 (RC3/CxIN3-), U6.2 (I2)
unnamed: U2.6 (RC4), U6.3 (I3)
unnamed: U2.5 (RC5), U6.4 (I4)
unnamed: R13.1, U4.3 (~WAKE)
~MCLR: C2.2, J1.1, R1.2, U2.4 (RA3/~MCLR), U4.2 (CS)

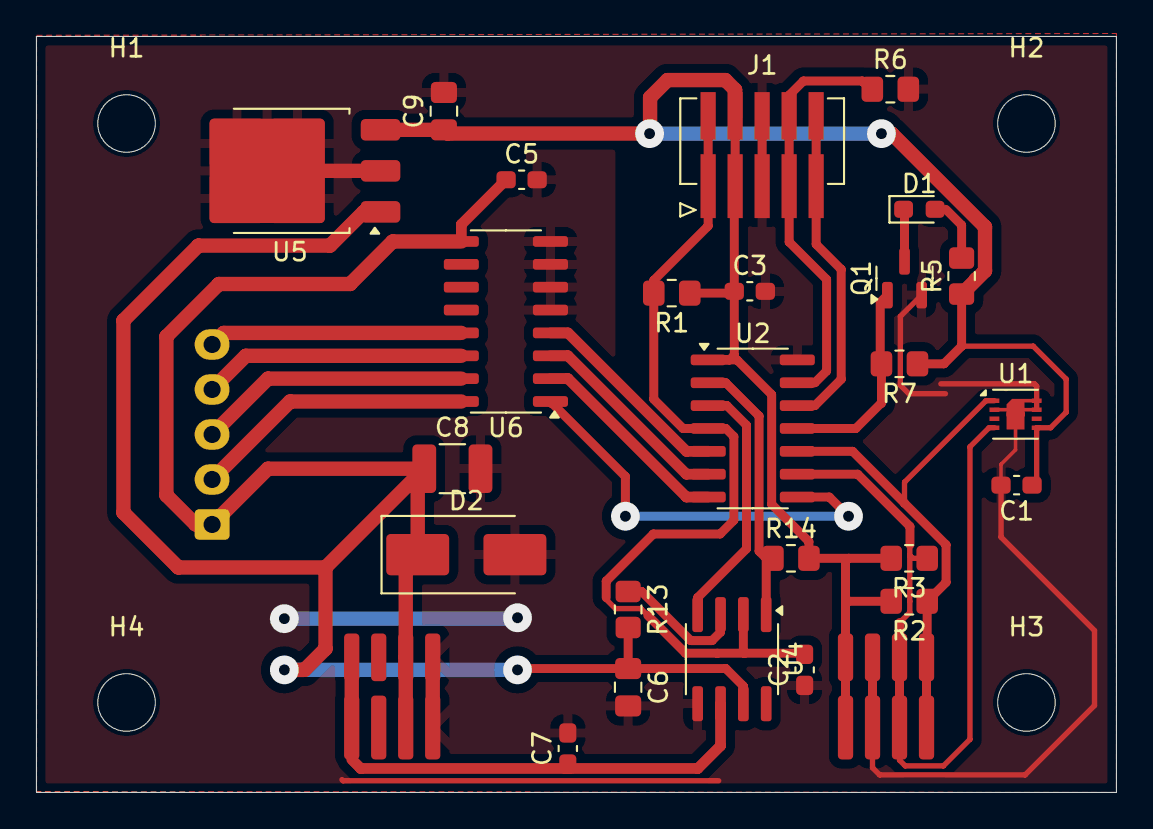
[picture p24: board ventil.kicad_pcb from above]

Board: 2 copper layers, 60.0 x 42.0 mm, 32 parts (1 on the bottom side), 23 nets.
