mbouyer/domotique/hardware/vmc/vmc.kicad_pcb

## KiCad design hardware/vmc/vmc.kicad_pcb (2025-04-17)

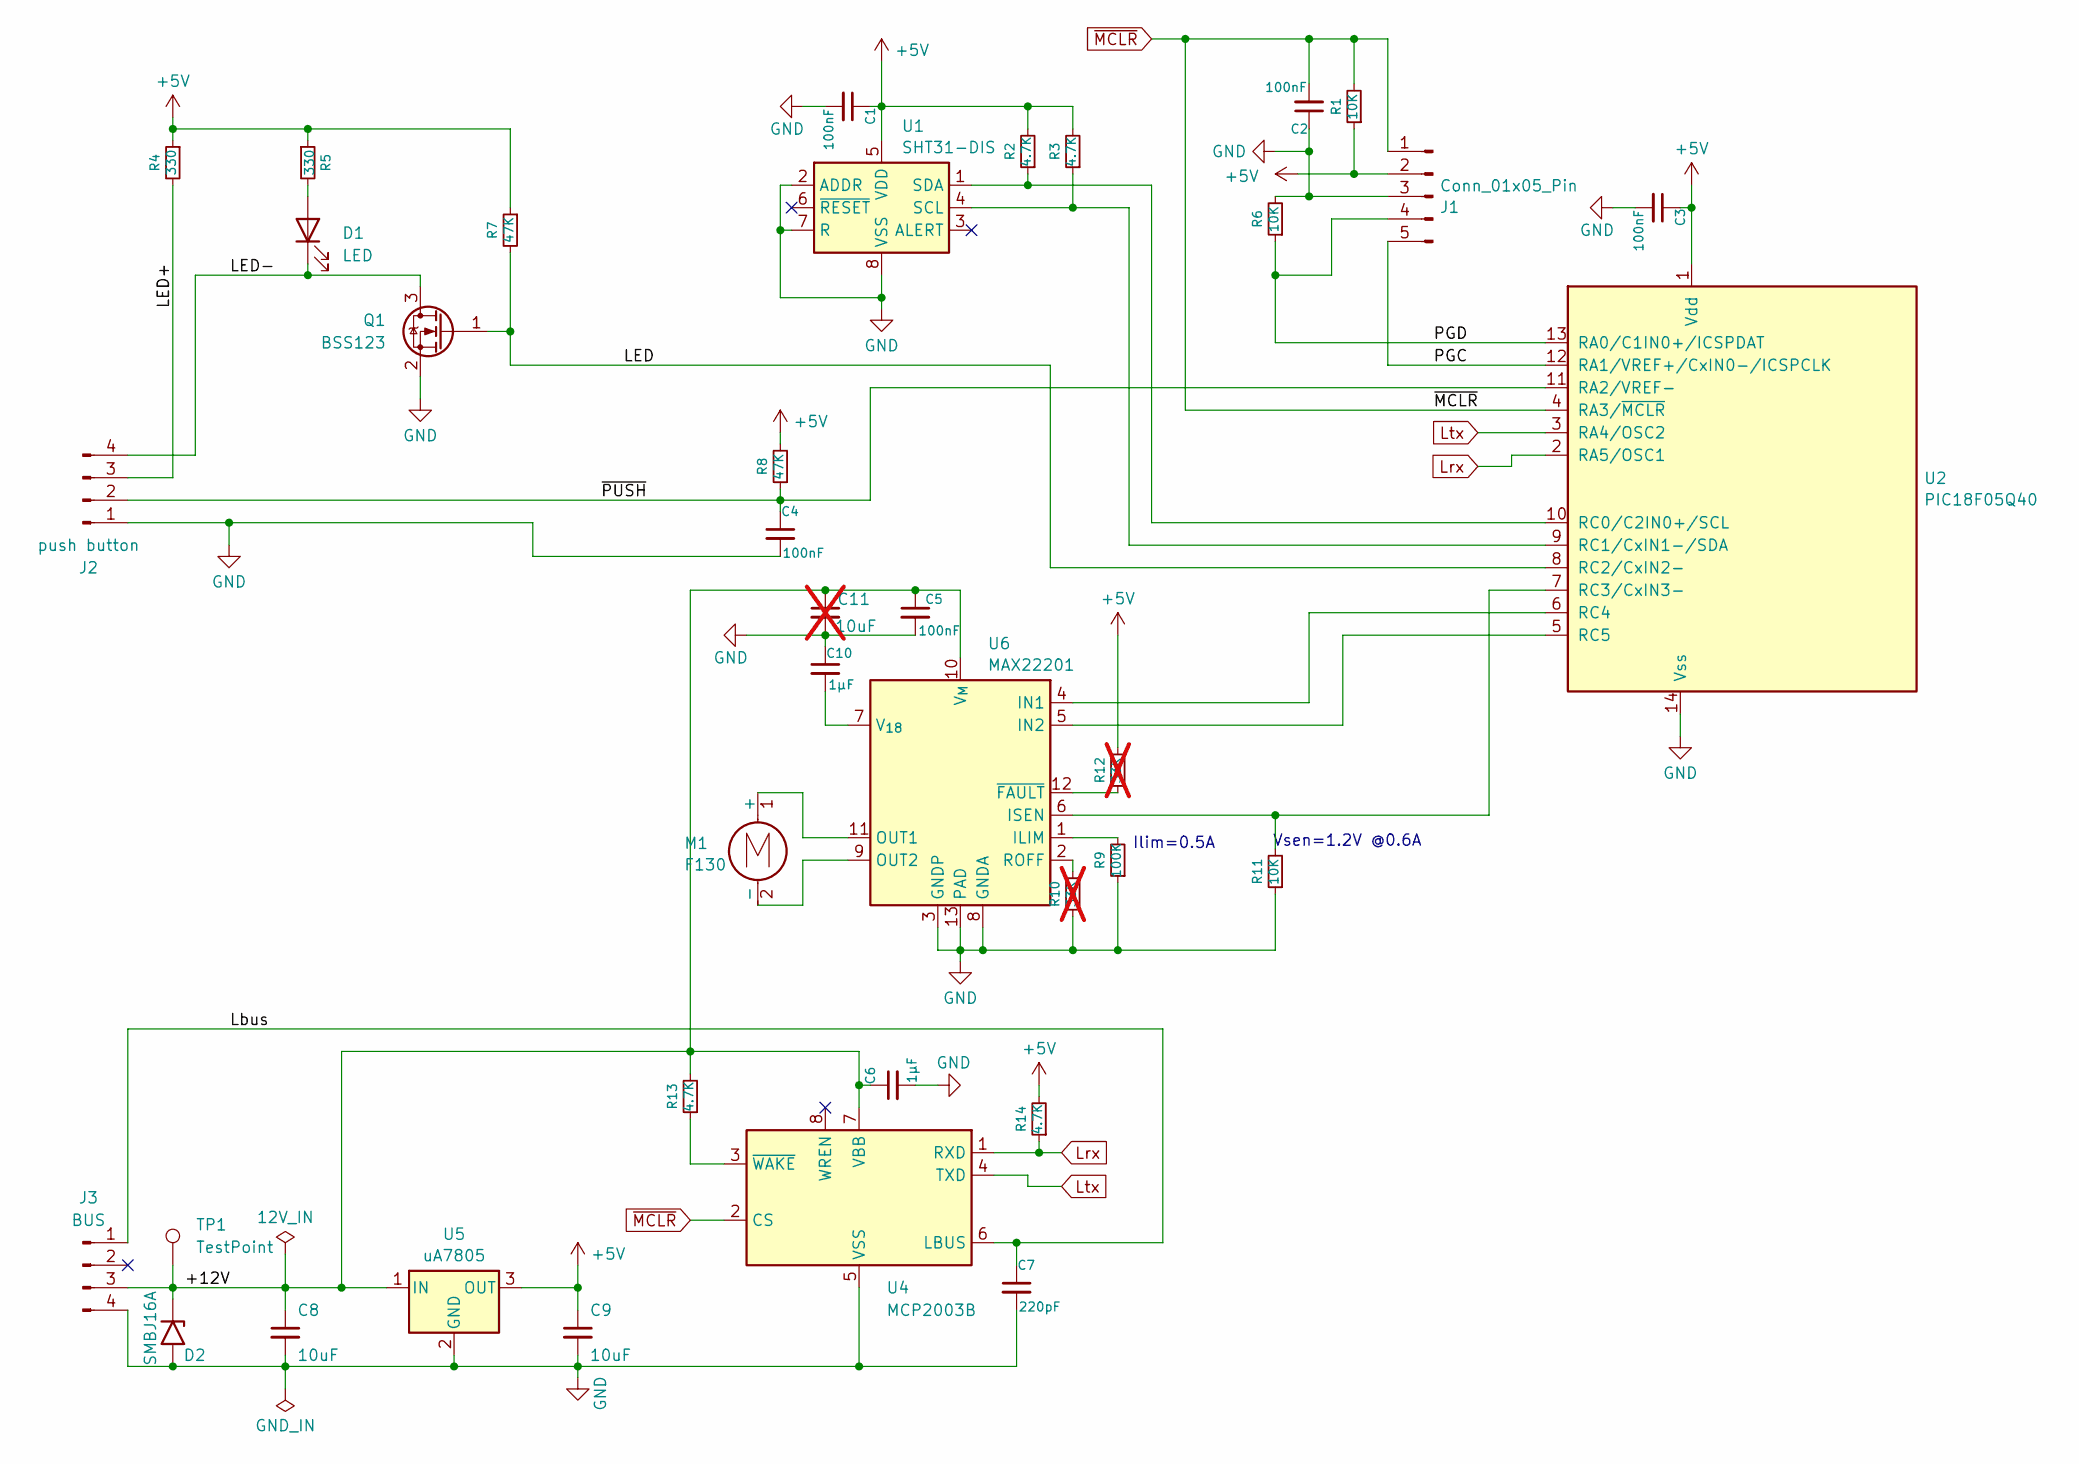
[picture p25: schematic vmc.kicad_sch]

Parts:
C1, C2, C3, C4, C5: 100nF; C_0603_1608Metric_Pad1.08x0.95mm_HandSolder
C6: 1µF; C_0805_2012Metric_Pad1.18x1.45mm_HandSolder
C7: 220pF; C_0603_1608Metric_Pad1.08x0.95mm_HandSolder
C8: 10uF; C_1210_3225Metric_Pad1.33x2.70mm_HandSolder
C9: 10uF; C_0805_2012Metric_Pad1.18x1.45mm_HandSolder
C10: 1µF; C_0603_1608Metric_Pad1.08x0.95mm_HandSolder
C11: 10uF; C_1210_3225Metric_Pad1.33x2.70mm_HandSolder; not fitted
D1: LED; LED_0603_1608Metric_Pad1.05x0.95mm_HandSolder
D2: SMBJ16A; D_SMB_Handsoldering
J1: Conn_01x05_Pin; Molex_Pico-SPOX-5-Vertical
J2: push button; Molex Pico-SPOX-4_90
J3: BUS; Molex Pico-SPOX-4_90
M1: F130
Q1: BSS123; SOT-23
R1, R6, R11: 10K; R_0805_2012Metric_Pad1.20x1.40mm_HandSolder
R2, R3, R13, R14: 4.7K; R_0805_2012Metric_Pad1.20x1.40mm_HandSolder
R4, R5: 330; R_0805_2012Metric_Pad1.20x1.40mm_HandSolder
R7, R8: 47K; R_0805_2012Metric_Pad1.20x1.40mm_HandSolder
R9: 100K; R_0805_2012Metric_Pad1.20x1.40mm_HandSolder
R10, R12: 33K; R_0805_2012Metric_Pad1.20x1.40mm_HandSolder; not fitted
TP1: TestPoint; TestPoint_THTPad_D1.5mm_Drill0.7mm
U1: SHT31-DIS; Sensirion_DFN-8-1EP_2.5x2.5mm_P0.5mm_EP1.1x1.7mm
U2: PIC18F05Q40; SOIC-14_3.9x8.7mm_P1.27mm
U4: MCP2003B; SOIC-8_3.9x4.9mm_P1.27mm
U5: uA7805; TO-252-3_TabPin2
U6: MAX22201; Maxim_TDFN-12-1EP_3x3mm_P0.5mm_EP1.7x2.5mm

Connections:
+5V: C1.1, C3.1, C9.1, J1.2, R1.1, R2.2, R3.2, R4.1, R5.1, R7.1, R8.2, R12.2, R14.2, U1.5 (VDD), U2.1 (Vdd), U5.3 (OUT)
/+12V: C5.1, C6.1, C8.1, C11.1, D2.1 (A1), J3.3, R13.2, TP1.1, U4.7 (VBB), U5.1 (IN), U6.10 (V_{M})
/LED: Q1.1 (G), R7.2, U2.8 (RC2/CxIN2-)
/LED+: J2.3, R4.2
/LED-: D1.1 (K), J2.4, Q1.3 (D)
/Lbus: C7.1, J3.1, U4.6 (LBUS)
/PGC: J1.5, U2.12 (RA1/VREF+/CxIN0-/ICSPCLK)
/PGD: J1.4, R6.1, U2.13 (RA0/C1IN0+/ICSPDAT)
/~PUSH: C4.1, J2.2, R8.1, U2.11 (RA2/VREF-)
GND: C1.2, C2.1, C3.2, C4.2, C5.2, C6.2, C7.2, C8.2, C9.2, C10.1, C11.2, D2.2 (A2), J1.3, J2.1, J3.4, Q1.2 (S), R6.2, R9.1, R10.1, R11.1, U1.2 (ADDR), U1.7 (R), U1.8 (VSS), U1.9 (VSS), U2.14 (Vss), U4.5 (VSS), U5.2 (GND), U6.3 (GNDP), U6.8 (GNDA), U6.13 (PAD)
Lrx: R14.1, U2.2 (RA5/OSC1), U4.1 (RXD)
Ltx: U2.3 (RA4/OSC2), U4.4 (TXD)
unnamed: D1.2 (A), R5.2
unnamed: M1.1 (+), U6.11 (OUT1)
unnamed: M1.2 (-), U6.9 (OUT2)
unnamed: R3.1, U1.4 (SCL), U2.9 (RC1/CxIN1-/SDA)
unnamed: R2.1, U1.1 (SDA), U2.10 (RC0/C2IN0+/SCL)
unnamed: R11.2, U2.7 (RC3/CxIN3-), U6.6 (ISEN)
unnamed: U2.6 (RC4), U6.4 (IN1)
unnamed: U2.5 (RC5), U6.5 (IN2)
unnamed: R13.1, U4.3 (~WAKE)
unnamed: R9.2, U6.1 (ILIM)
unnamed: R10.2, U6.2 (ROFF)
unnamed: C10.2, U6.7 (V_{18})
unnamed: R12.1, U6.12 (~FAULT)
~MCLR: C2.2, J1.1, R1.2, U2.4 (RA3/~MCLR), U4.2 (CS)

Notes on the sheet:
Ilim=0.5A
Vsen=1.2V @0.6A

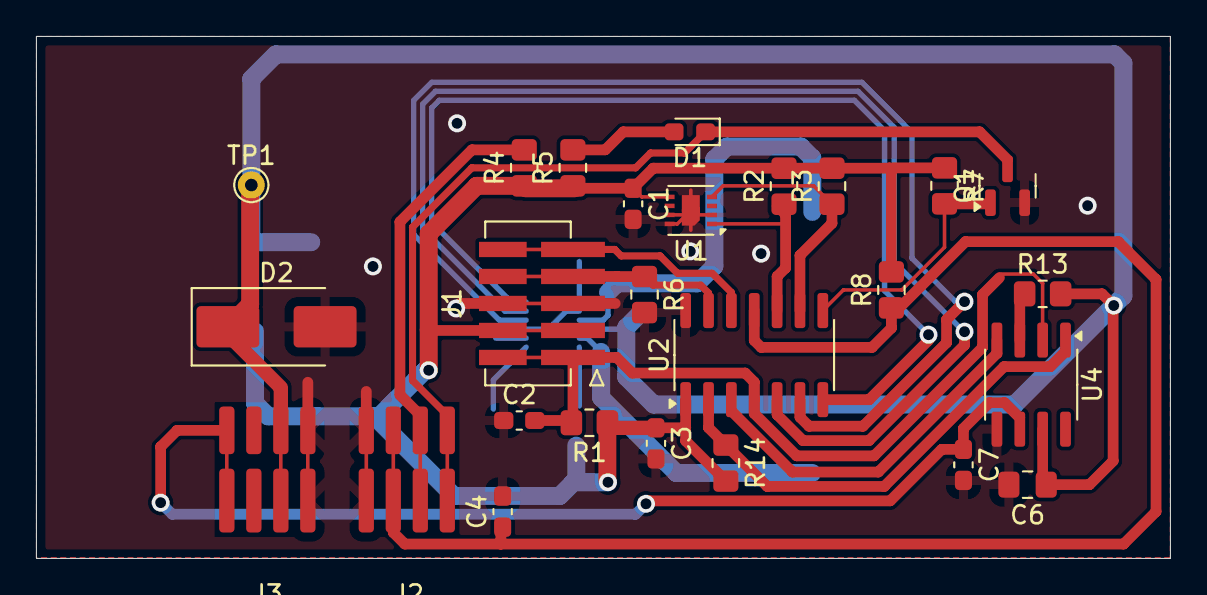
[picture p26: board vmc.kicad_pcb from above]

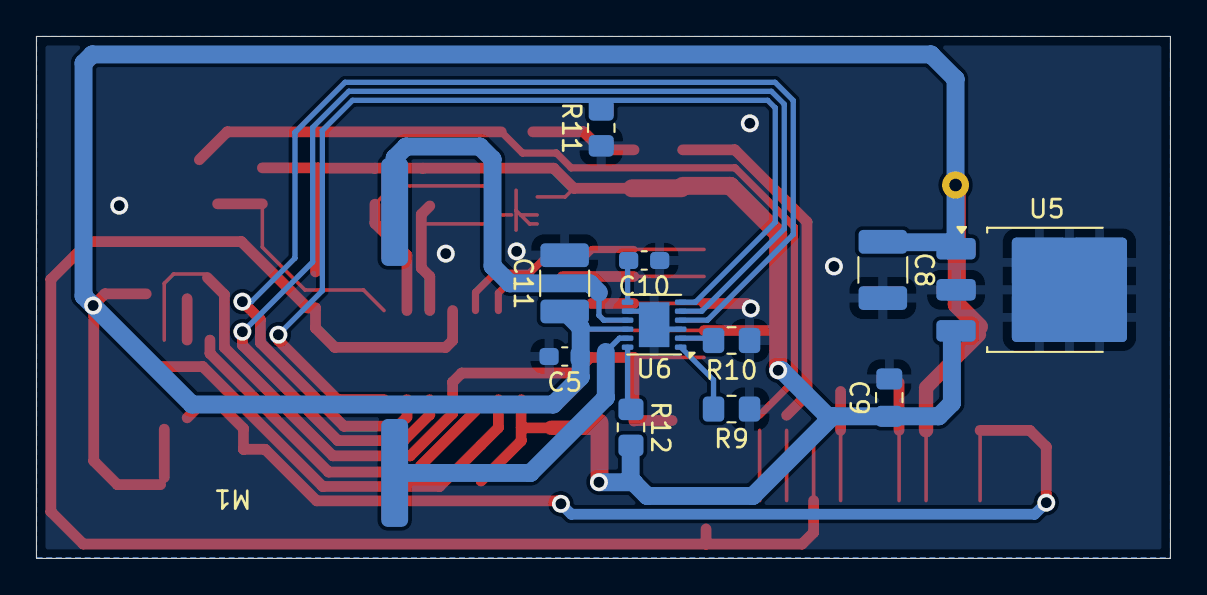
[picture p27: board vmc.kicad_pcb from below]

Board: 2 copper layers, 63.0 x 29.0 mm, 38 parts (12 on the bottom side), 26 nets.
