mbouyer/domotique/hardware/energie/energie.kicad_pcb

## KiCad design hardware/energie/energie.kicad_pcb (2024-12-18)

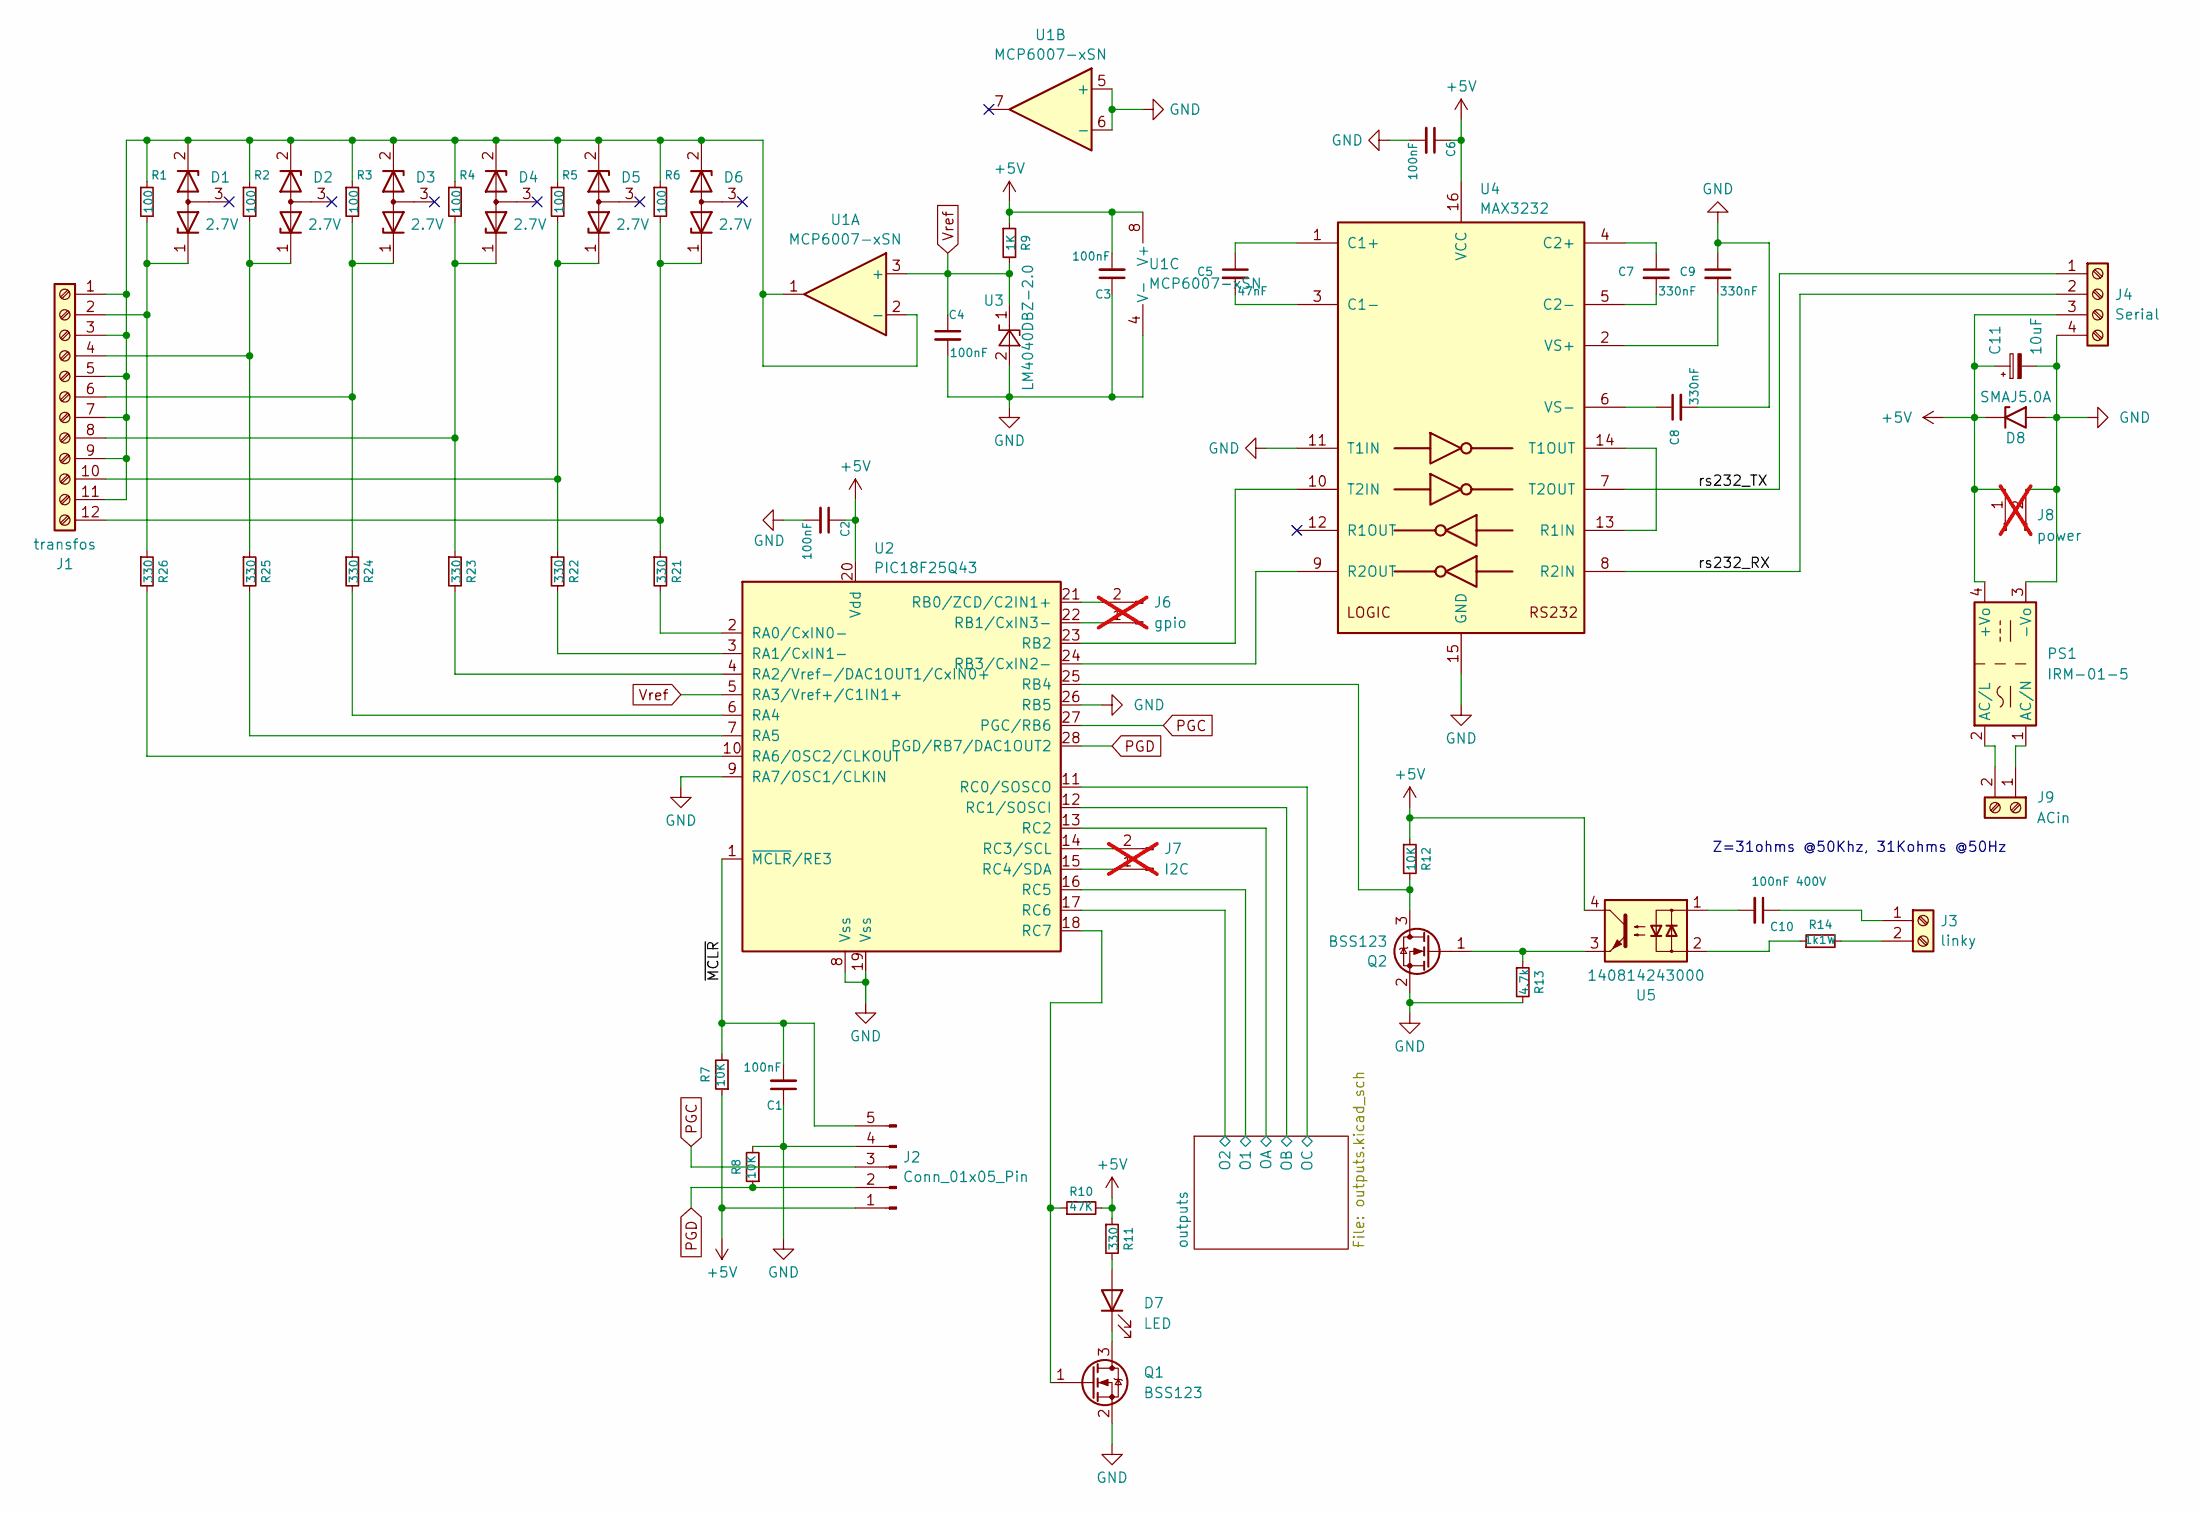
[picture p28: schematic energie.kicad_sch]

Parts:
C1, C2, C3, C4, C6: 100nF; C_0603_1608Metric_Pad1.08x0.95mm_HandSolder
C5: 47nF; C_0603_1608Metric_Pad1.08x0.95mm_HandSolder
C7, C8, C9: 330nF; C_0603_1608Metric_Pad1.08x0.95mm_HandSolder
C10: 100nF 400V; C_1808_4520Metric_Pad1.72x2.30mm_HandSolder
C11: 10uF; C_0805_2012Metric_Pad1.18x1.45mm_HandSolder
D1, D2, D3, D4, D5, D6: 2.7V; SOT-23_Handsoldering
D7: LED; LED_0603_1608Metric_Pad1.05x0.95mm_HandSolder
D8: SMAJ5.0A; D_SMA
J1: transfos; PhoenixContact_MCV_1,5_12-G-3.5_1x12_P3.50mm_Vertical
J2: Conn_01x05_Pin; PinHeader_1x05_P2.54mm_Vertical
J3: linky; PhoenixContact_MCV_1,5_2-G-3.5_1x02_P3.50mm_Vertical
J4: Serial; PhoenixContact_MCV_1,5_4-G-3.5_1x04_P3.50mm_Vertical
J6: gpio; PinHeader_1x02_P2.54mm_Vertical_SMD_Pin1Left; not fitted
J7: I2C; PinHeader_1x02_P2.54mm_Vertical_SMD_Pin1Left; not fitted
J8: power; PinHeader_1x02_P2.54mm_Vertical; not fitted
J9: ACin; PhoenixContact_MCV_1,5_2-G-3.5_1x02_P3.50mm_Vertical
PS1: IRM-01-5; Converter_ACDC_MeanWell_IRM-02-xx_THT
Q1, Q2: BSS123; SOT-23
R1, R2, R3, R4, R5, R6: 100; R_0805_2012Metric_Pad1.20x1.40mm_HandSolder
R7, R8, R12: 10K; R_0805_2012Metric_Pad1.20x1.40mm_HandSolder
R9: 1K; R_0805_2012Metric_Pad1.20x1.40mm_HandSolder
R10: 47K; R_0805_2012Metric_Pad1.20x1.40mm_HandSolder
R11, R21, R22, R23, R24, R25, R26: 330; R_0805_2012Metric_Pad1.20x1.40mm_HandSolder
R13: 4.7k; R_0805_2012Metric_Pad1.20x1.40mm_HandSolder
R14: 1k1W; R_2512_6332Metric_Pad1.40x3.35mm_HandSolder
U1: MCP6007-xSN; SOIC-8_3.9x4.9mm_P1.27mm
U2: PIC18F25Q43; SOIC-28W_7.5x18.7mm_P1.27mm
U3: LM4040DBZ-2.0; SOT-23
U4: MAX3232; SOIC-16_3.9x9.9mm_P1.27mm
U5: 140814243000; SMDIP-4_W9.53mm

Connections:
+5V: C2.1, C3.2, C6.1, C11.1, D8.1 (A1), J2.1, J4.3, J8.1, PS1.4 (+Vo), R7.1, R9.1, R10.2, R11.1, R12.1, U1.8 (V+), U2.20 (Vdd), U4.16 (VCC), U5.4
/outputs/O1: U2.16 (RC5); also elsewhere on the board
/outputs/O2: U2.17 (RC6); also elsewhere on the board
/outputs/OA: U2.13 (RC2); also elsewhere on the board
/outputs/OB: U2.12 (RC1/SOSCI); also elsewhere on the board
/outputs/OC: U2.11 (RC0/SOSCO); also elsewhere on the board
/rs232_RX: J4.2, U4.8 (R2IN)
/rs232_TX: J4.1, U4.7 (T2OUT)
/~MCLR: C1.2, J2.5, R7.2, U2.1 (~MCLR/RE3)
GND: C1.1, C2.2, C3.1, C4.2, C6.2, C8.2, C9.1, C11.2, D8.2 (A2), J2.4, J4.4, J8.2, PS1.3 (-Vo), Q1.2 (S), Q2.2 (S), R8.2, R13.2, U1.4 (V-), U1.5 (+), U1.6 (-), U2.8 (Vss), U2.9 (RA7/OSC1/CLKIN), U2.19 (Vss), U2.26 (RB5), U3.2 (A), U4.11 (T1IN), U4.15 (GND)
unnamed: C10.2, U5.1
unnamed: D7.2 (A), R11.2
unnamed: D7.1 (K), Q1.3 (D)
unnamed: D1.2 (K), D2.2 (K), D3.2 (K), D4.2 (K), D5.2 (K), D6.2 (K), J1.1, J1.3, J1.5, J1.7, J1.9, J1.11, R1.1, R2.1, R3.1, R4.1, R5.1, R6.1, U1.1, U1.2 (-)
unnamed: D1.1 (K), J1.2, R1.2, R26.1
unnamed: D2.1 (K), J1.4, R2.2, R25.1
unnamed: D3.1 (K), J1.6, R3.2, R24.1
unnamed: D4.1 (K), J1.8, R4.2, R23.1
unnamed: D5.1 (K), J1.10, R5.2, R22.1
unnamed: D6.1 (K), J1.12, R6.2, R21.1
unnamed: C10.1, J3.1
unnamed: J3.2, R14.2
unnamed: J6.1, U2.22 (RB1/CxIN3-)
unnamed: J6.2, U2.21 (RB0/ZCD/C2IN1+)
unnamed: J7.1, U2.15 (RC4/SDA)
unnamed: J7.2, U2.14 (RC3/SCL)
unnamed: J9.1, PS1.1 (AC/N)
unnamed: J9.2, PS1.2 (AC/L)
unnamed: Q1.1 (G), R10.1, U2.18 (RC7)
unnamed: Q2.3 (D), R12.2, U2.25 (RB4)
unnamed: Q2.1 (G), R13.1, U5.3
unnamed: R14.1, U5.2
unnamed: R21.2, U2.2 (RA0/CxIN0-)
unnamed: R22.2, U2.3 (RA1/CxIN1-)
unnamed: R23.2, U2.4 (RA2/Vref-/DAC1OUT1/CxIN0+)
unnamed: R24.2, U2.6 (RA4)
unnamed: R25.2, U2.7 (RA5)
unnamed: R26.2, U2.10 (RA6/OSC2/CLKOUT)
unnamed: U2.23 (RB2), U4.10 (T2IN)
unnamed: U2.24 (RB3/CxIN2-), U4.9 (R2OUT)
unnamed: C5.1, U4.1 (C1+)
unnamed: C5.2, U4.3 (C1-)
unnamed: C7.1, U4.4 (C2+)
unnamed: C7.2, U4.5 (C2-)
unnamed: U4.13 (R1IN), U4.14 (T1OUT)
unnamed: C9.2, U4.2 (VS+)
unnamed: C8.1, U4.6 (VS-)
PGC: J2.3, U2.27 (PGC/RB6)
PGD: J2.2, R8.1, U2.28 (PGD/RB7/DAC1OUT2)
Vref: C4.1, R9.2, U1.3 (+), U2.5 (RA3/Vref+/C1IN1+), U3.1 (K)

Notes on the sheet:
Z=31ohms @50Khz, 31Kohms @50Hz

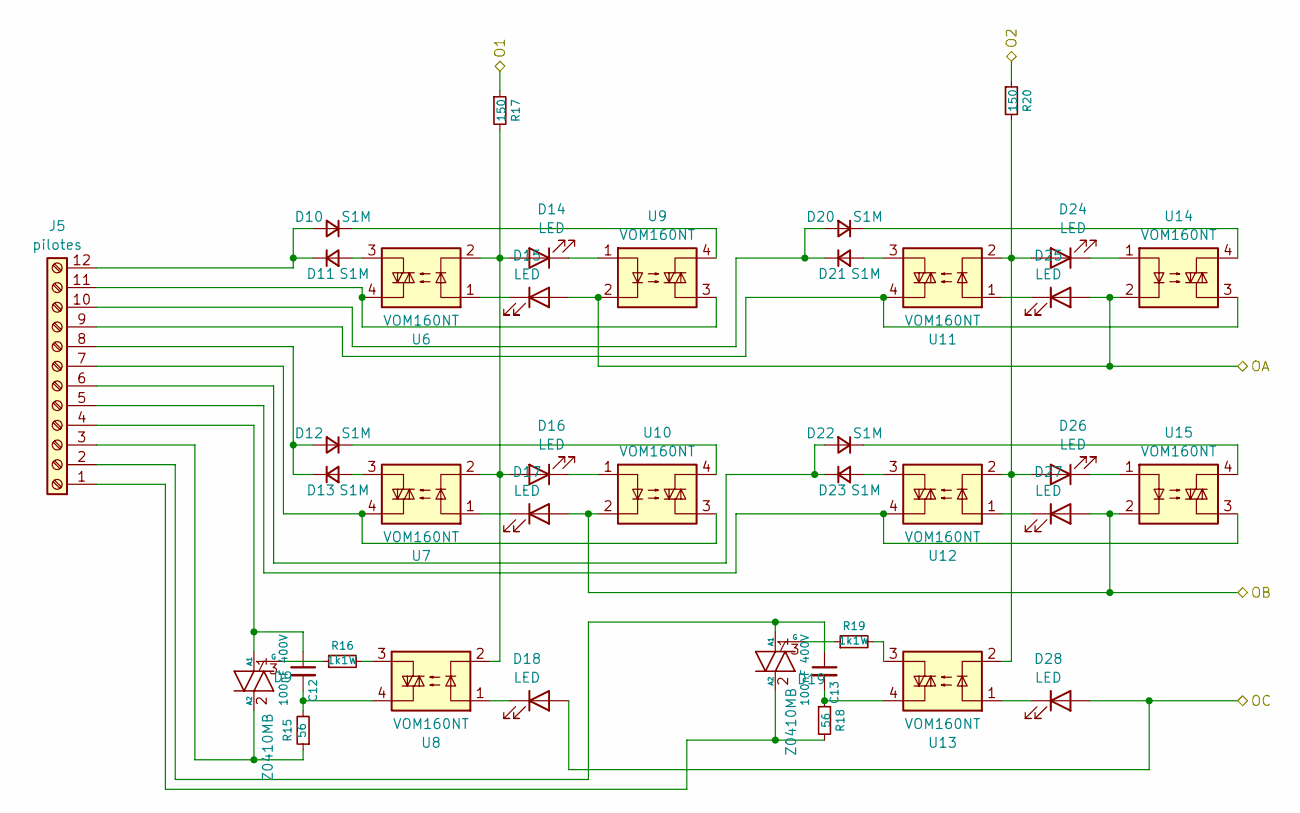
[picture p29: schematic outputs.kicad_sch]

Parts:
C12, C13: 100nF 400V; C_1808_4520Metric_Pad1.72x2.30mm_HandSolder
D9, D19: Z0410MB; TO-252-2
D10, D11, D12, D13, D20, D21, D22, D23: S1M; D_SMA
D14, D15, D16, D17, D18, D24, D25, D26, D27, D28: LED; LED_0603_1608Metric_Pad1.05x0.95mm_HandSolder
J5: pilotes; PhoenixContact_MCV_1,5_12-G-3.5_1x12_P3.50mm_Vertical
R15, R18: 56; R_2512_6332Metric_Pad1.40x3.35mm_HandSolder
R16, R19: 1k1W; R_2512_6332Metric_Pad1.40x3.35mm_HandSolder
R17, R20: 150; R_0805_2012Metric_Pad1.20x1.40mm_HandSolder
U6, U7, U8, U9, U10, U11, U12, U13, U14, U15: VOM160NT; VOM160

Connections:
/outputs/O1: R17.1; also elsewhere on the board
/outputs/O2: R20.1; also elsewhere on the board
/outputs/OA: D15.2 (A), D25.2 (A), U9.2, U14.2; also elsewhere on the board
/outputs/OB: D17.2 (A), D27.2 (A), U10.2, U15.2; also elsewhere on the board
/outputs/OC: D18.2 (A), D28.2 (A); also elsewhere on the board
unnamed: C12.2, R15.2, U8.4
unnamed: C13.2, R18.1, U13.4
unnamed: C12.1, D9.1 (A1), J5.4
unnamed: D9.2 (A2), J5.3, R15.1
unnamed: D9.3 (G), R16.1
unnamed: D10.2 (A), D11.1 (K), J5.12
unnamed: D10.1 (K), U9.4
unnamed: D11.2 (A), U6.3
unnamed: D12.2 (A), D13.1 (K), J5.8
unnamed: D12.1 (K), U10.4
unnamed: D13.2 (A), U7.3
unnamed: D14.2 (A), D16.2 (A), R17.2, U6.2, U7.2, U8.2
unnamed: D14.1 (K), U9.1
unnamed: D15.1 (K), U6.1
unnamed: D16.1 (K), U10.1
unnamed: D17.1 (K), U7.1
unnamed: D18.1 (K), U8.1
unnamed: C13.1, D19.1 (A1), J5.2
unnamed: D19.2 (A2), J5.1, R18.2
unnamed: D19.3 (G), R19.1
unnamed: D20.2 (A), D21.1 (K), J5.10
unnamed: D20.1 (K), U14.4
unnamed: D21.2 (A), U11.3
unnamed: D22.2 (A), D23.1 (K), J5.6
unnamed: D22.1 (K), U15.4
unnamed: D23.2 (A), U12.3
unnamed: D24.2 (A), D26.2 (A), R20.2, U11.2, U12.2, U13.2
unnamed: D24.1 (K), U14.1
unnamed: D25.1 (K), U11.1
unnamed: D26.1 (K), U15.1
unnamed: D27.1 (K), U12.1
unnamed: D28.1 (K), U13.1
unnamed: J5.5, U12.4, U15.3
unnamed: J5.7, U7.4, U10.3
unnamed: J5.9, U11.4, U14.3
unnamed: J5.11, U6.4, U9.3
unnamed: R16.2, U8.3
unnamed: R19.2, U13.3

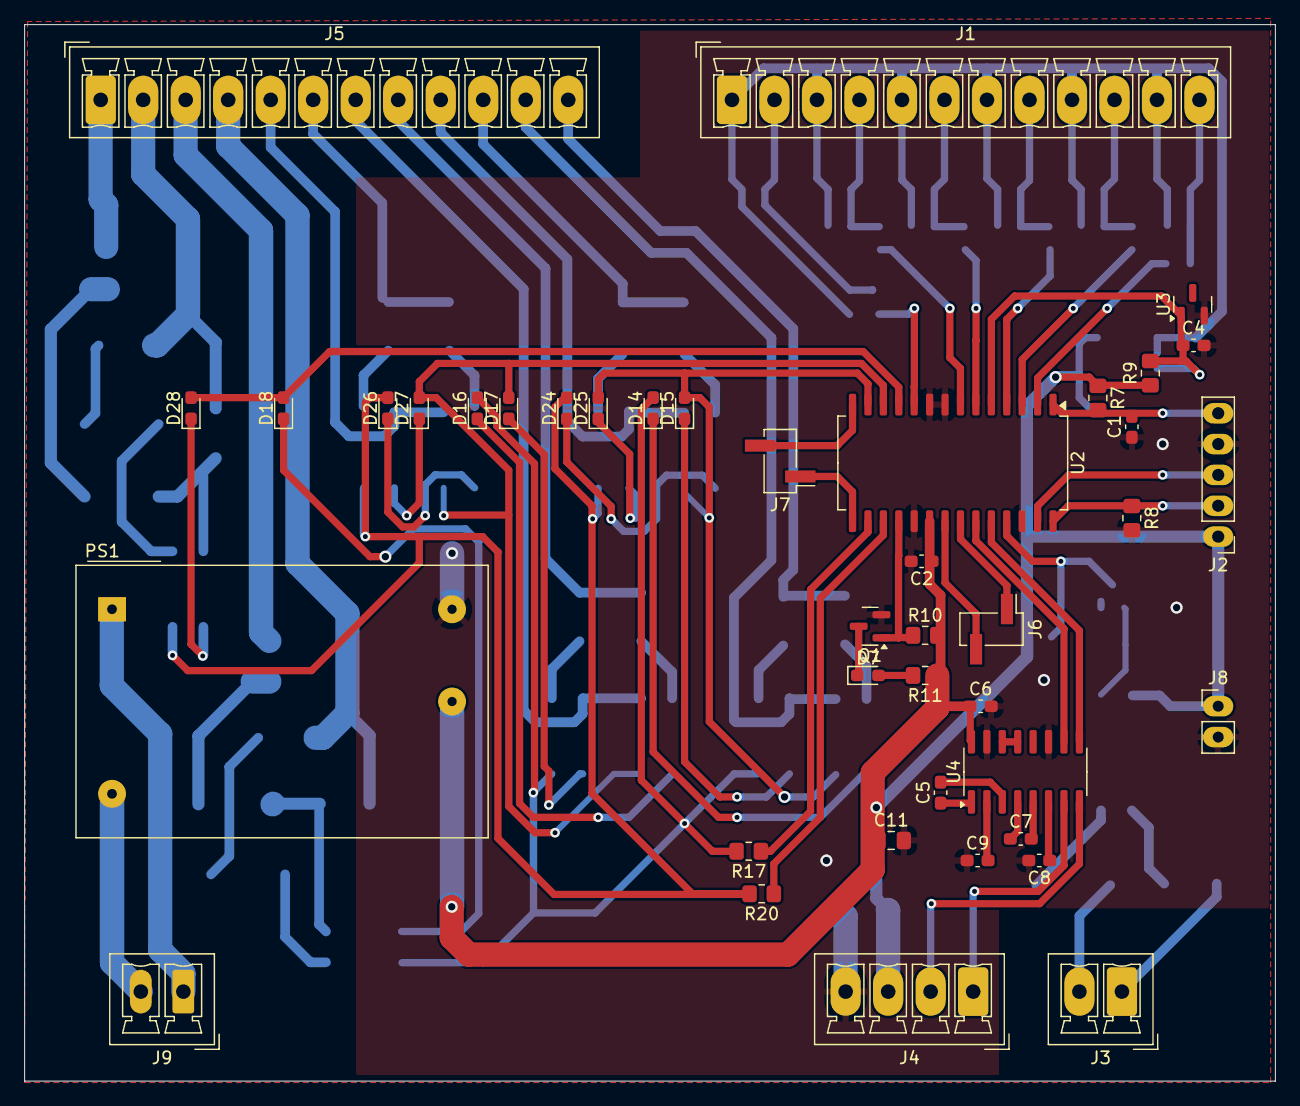
[picture p30: board energie.kicad_pcb from above]

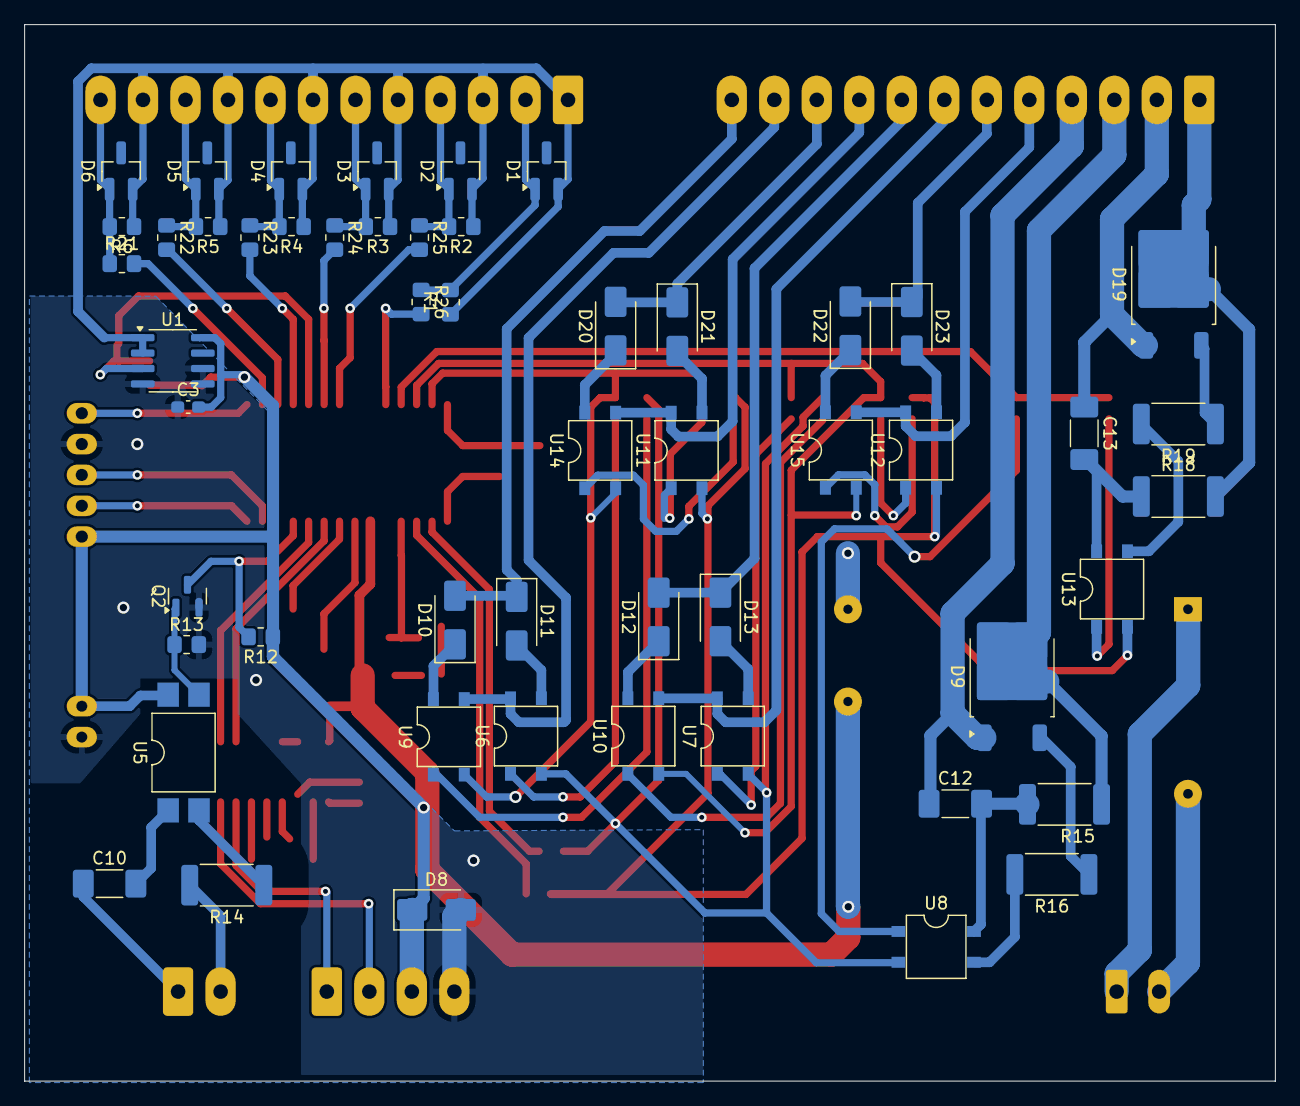
[picture p31: board energie.kicad_pcb from below]

Board: 2 copper layers, 103.0 x 87.0 mm, 94 parts (53 on the bottom side), 88 nets.
