mbouyer/domotique/hardware/rsr232-iso/rsr232-iso.kicad_pcb

## KiCad design hardware/rsr232-iso/rsr232-iso.kicad_pcb (2024-12-12)

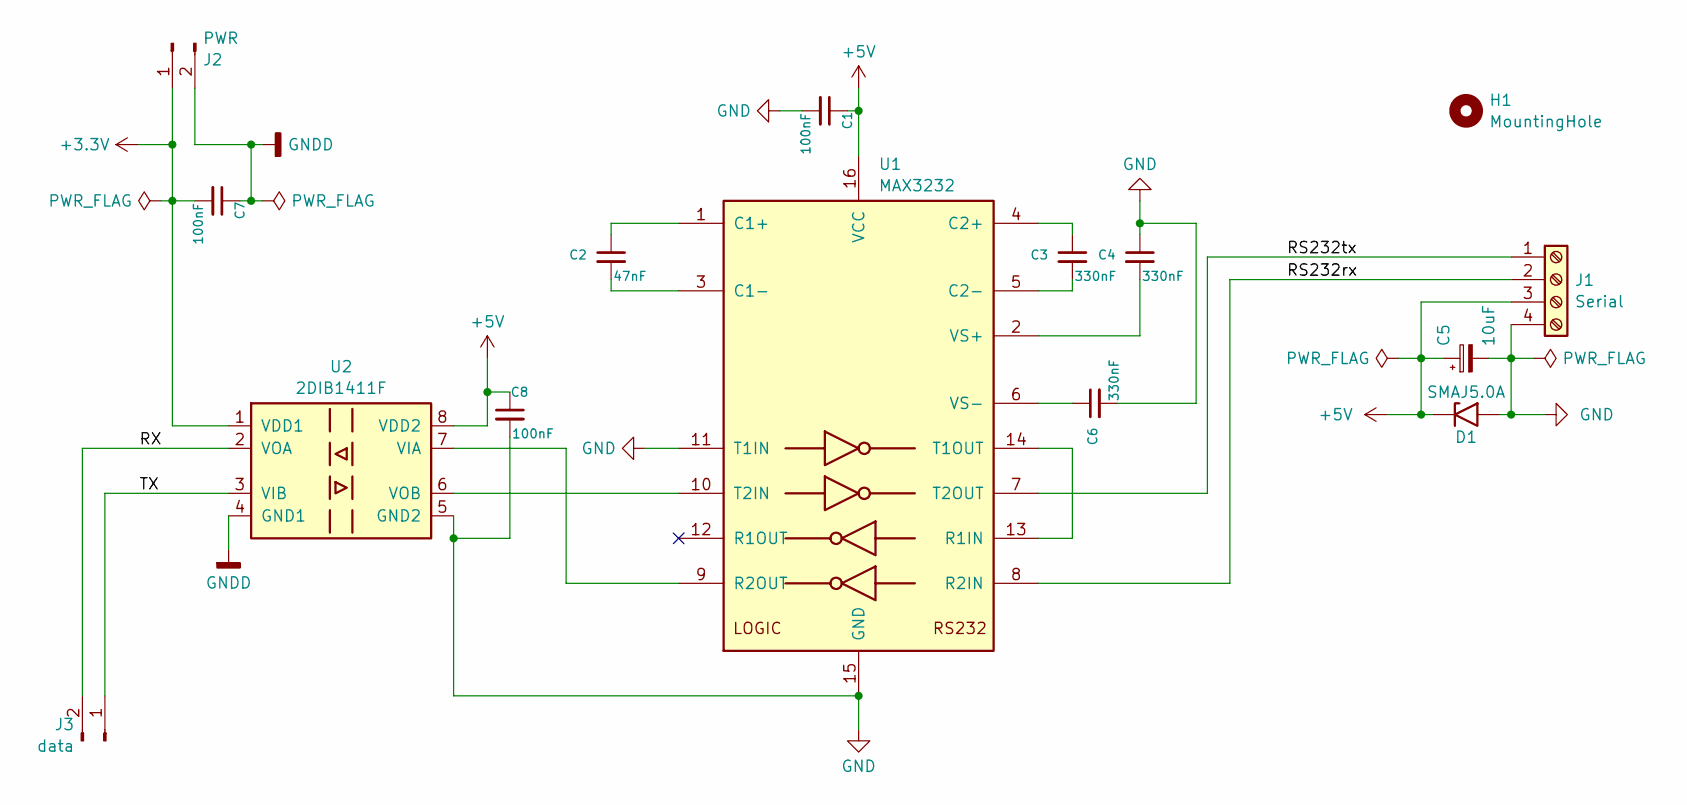
[picture p32: schematic rsr232-iso.kicad_sch]

Parts:
C1, C7, C8: 100nF; C_0603_1608Metric_Pad1.08x0.95mm_HandSolder
C2: 47nF; C_0603_1608Metric_Pad1.08x0.95mm_HandSolder
C3, C4, C6: 330nF; C_0603_1608Metric_Pad1.08x0.95mm_HandSolder
C5: 10uF; C_0805_2012Metric_Pad1.18x1.45mm_HandSolder
D1: SMAJ5.0A; D_SMA
H1: MountingHole; MountingHole_3.2mm_M3_DIN965
J1: Serial; PhoenixContact_MCV_1,5_4-G-3.5_1x04_P3.50mm_Vertical
J2: PWR; PinHeader_1x02_P2.54mm_Vertical
J3: data; PinHeader_1x02_P2.54mm_Vertical
U1: MAX3232; SOIC-16_3.9x9.9mm_P1.27mm
U2: 2DIB1411F; SOIC-8_3.9x4.9mm_P1.27mm

Connections:
+3.3V: C7.2, J2.1, U2.1 (VDD1)
+5V: C1.1, C5.1, C8.1, D1.1 (A1), J1.3, U1.16 (VCC), U2.8 (VDD2)
/RS232rx: J1.2, U1.8 (R2IN)
/RS232tx: J1.1, U1.7 (T2OUT)
/RX: J3.2, U2.2 (VOA)
/TX: J3.1, U2.3 (VIB)
GND: C1.2, C4.1, C5.2, C6.2, C8.2, D1.2 (A2), J1.4, U1.11 (T1IN), U1.15 (GND), U2.5 (GND2)
GNDD: C7.1, J2.2, U2.4 (GND1)
unnamed: C2.1, U1.1 (C1+)
unnamed: C2.2, U1.3 (C1-)
unnamed: C3.1, U1.4 (C2+)
unnamed: C3.2, U1.5 (C2-)
unnamed: U1.13 (R1IN), U1.14 (T1OUT)
unnamed: U1.9 (R2OUT), U2.7 (VIA)
unnamed: U1.10 (T2IN), U2.6 (VOB)
unnamed: C4.2, U1.2 (VS+)
unnamed: C6.1, U1.6 (VS-)

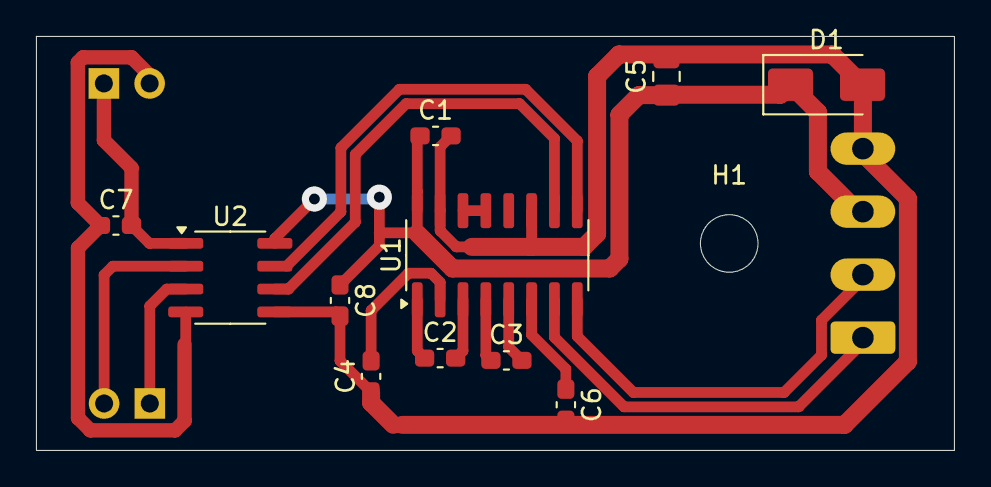
[picture p33: board rsr232-iso.kicad_pcb from above]

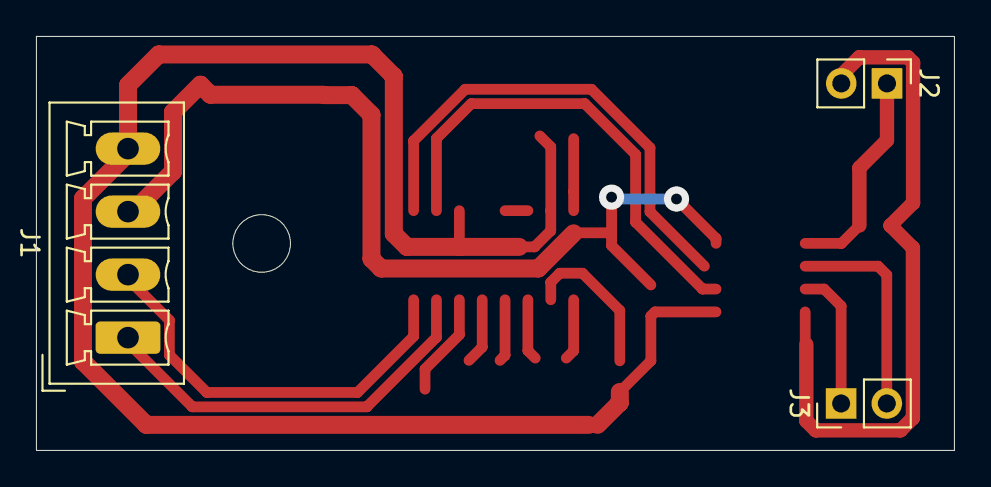
[picture p34: board rsr232-iso.kicad_pcb from below]

Board: 2 copper layers, 51.0 x 23.0 mm, 15 parts (3 on the bottom side), 17 nets.
