mbouyer/domotique/hardware/linky-serial/linky-serial.kicad_pcb

## KiCad design hardware/linky-serial/linky-serial.kicad_pcb (2024-12-10)

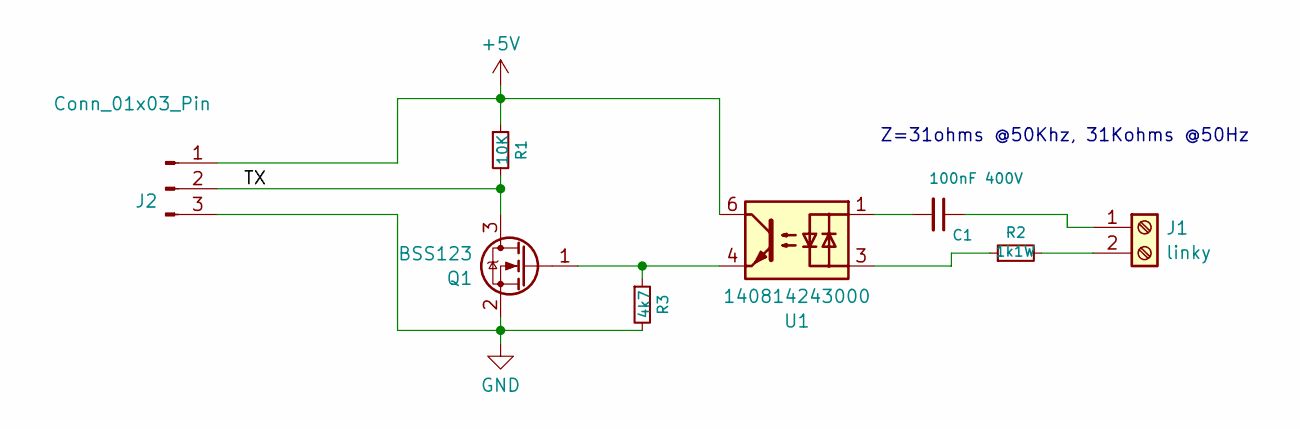
[picture p35: schematic linky-serial.kicad_sch]

Parts:
C1: 100nF 400V; C_1812_4532Metric
J1: linky; PhoenixContact_MCV_1,5_2-G-3.5_1x02_P3.50mm_Vertical
J2: Conn_01x03_Pin; PinHeader_1x03_P2.54mm_Vertical
Q1: BSS123; SOT-23
R1: 10K; R_0805_2012Metric_Pad1.20x1.40mm_HandSolder
R2: 1k1W; R_2512_6332Metric_Pad1.40x3.35mm_HandSolder
R3: 4k7; R_0805_2012Metric_Pad1.20x1.40mm_HandSolder
U1: 140814243000; MFSOP6-4_4.4x3.6mm_P1.27mm

Connections:
+5V: J2.1, R1.1, U1.6
/TX: J2.2, Q1.3 (D), R1.2
GND: J2.3, Q1.2 (S), R3.2
unnamed: C1.2, U1.1
unnamed: C1.1, J1.1
unnamed: J1.2, R2.2
unnamed: Q1.1 (G), R3.1, U1.4
unnamed: R2.1, U1.3

Notes on the sheet:
Z=31ohms @50Khz, 31Kohms @50Hz

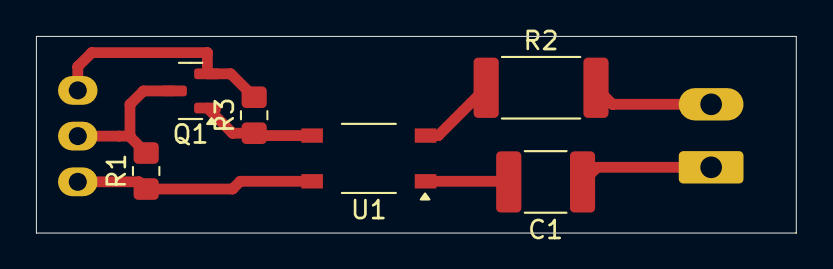
[picture p36: board linky-serial.kicad_pcb from above]

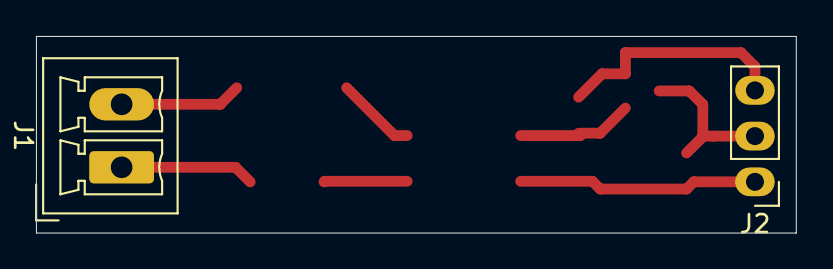
[picture p37: board linky-serial.kicad_pcb from below]

Board: 2 copper layers, 42.2 x 10.9 mm, 8 parts (2 on the bottom side), 8 nets.
