mbouyer/domotique/software/energie/serial.c

/* $Id: serial.c,v 1.2 2017/06/05 11:00:19 bouyer Exp $ */
/*
 * Copyright (c) 2024 Manuel Bouyer
 *
 * All rights reserved.
 *
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
 * THIS SOFTWARE IS PROVIDED BY THE NETBSD FOUNDATION, INC. AND CONTRIBUTORS
 * ``AS IS'' AND ANY EXPRESS OR IMPLIED WARRANTIES, INCLUDING, BUT NOT LIMITED
 * TO, THE IMPLIED WARRANTIES OF MERCHANTABILITY AND FITNESS FOR A PARTICULAR
 * PURPOSE ARE DISCLAIMED.  IN NO EVENT SHALL THE FOUNDATION OR CONTRIBUTORS
 * BE LIABLE FOR ANY DIRECT, INDIRECT, INCIDENTAL, SPECIAL, EXEMPLARY, OR
 * CONSEQUENTIAL DAMAGES (INCLUDING, BUT NOT LIMITED TO, PROCUREMENT OF
 * SUBSTITUTE GOODS OR SERVICES; LOSS OF USE, DATA, OR PROFITS; OR BUSINESS
 * INTERRUPTION) HOWEVER CAUSED AND ON ANY THEORY OF LIABILITY, WHETHER IN
 * CONTRACT, STRICT LIABILITY, OR TORT (INCLUDING NEGLIGENCE OR OTHERWISE)
 * ARISING IN ANY WAY OUT OF THE USE OF THIS SOFTWARE, EVEN IF ADVISED OF THE
 * POSSIBILITY OF SUCH DAMAGE.
 */

#include <xc.h>
#include <stdio.h>
#include <serial.h>

/* statistisc */
unsigned char rx_debug_ov;
unsigned char tx_debug_w;
unsigned char rx_232_ov;
unsigned char rx_232_cs;
unsigned char tx_232_w;
unsigned char rx_linky_ov;
unsigned char rx_linky_cs;

/* uart1 (debug) support */

char uart_txbuf[UART_TXBUFSIZE];
unsigned char uart_txbuf_prod;
volatile unsigned char uart_txbuf_cons;

void
usart_putchar (char c)
{
#if 1
	unsigned char new_uart_txbuf_prod = (uart_txbuf_prod + 1) & UART_TXBUFSIZE_MASK;

again:
	if (new_uart_txbuf_prod == uart_txbuf_cons) {
		tx_debug_w++;
		while (new_uart_txbuf_prod == uart_txbuf_cons) {
			PIE4bits.U1TXIE = 1; /* ensure we'll make progress */
		}
	}
	uart_txbuf[uart_txbuf_prod] = c;
	uart_txbuf_prod = new_uart_txbuf_prod;
	PIE4bits.U1TXIE = 1;
	if (c == '\n') {
		c = '\r';
		new_uart_txbuf_prod = (uart_txbuf_prod + 1) & UART_TXBUFSIZE_MASK;
		goto again;
	}
#else
	char d = c;
again:
	if  (!PIR4bits.U1TXIF) {
		goto again;
	}
	U1TXB = d;
	if (d == '\n') {
		d = '\r';
		goto again;
	}
#endif
}

void __interrupt(__irq(U1TX), __low_priority, base(IVECT_BASE))
irql_uart1tx(void)
{
	if (PIE4bits.U1TXIE && PIR4bits.U1TXIF) {
		if (uart_txbuf_prod == uart_txbuf_cons) {
			PIE4bits.U1TXIE = 0; /* buffer empty */
		} else {
			/* Place char in TXREG - this starts transmition */
			U1TXB = uart_txbuf[uart_txbuf_cons];
			uart_txbuf_cons = (uart_txbuf_cons + 1) & UART_TXBUFSIZE_MASK;
		}
	}
}

char uart_rxbuf1[UART_RXBUFSIZE];
char uart_rxbuf2[UART_RXBUFSIZE];
unsigned char uart_rxbuf_idx;
unsigned char uart_rxbuf_a;
volatile union uart_softintrs uart_softintrs;

void __interrupt(__irq(U1RX), __low_priority, base(IVECT_BASE))
irql_uart1rx(void)
{
	if (PIR4bits.U1RXIF) {
		char c;

		if (U1ERRIRbits.RXFOIF || U1ERRIRbits.FERIF) {
			c = U1RXB;
			(void)c;
			U1ERRIRbits.RXFOIF = 0;
			/* error; ignore line */
			rx_232_cs++;
			uart_rxbuf_idx = UART_RXBUFSIZE;
			return;
		}

		c = U1RXB;
		if (c == 0x0a)
			return;

		if (uart_rxbuf_idx == UART_RXBUFSIZE) {
			/* overflow, reset on \n */
			if (c == 0x0d) {
				rx_debug_ov++;
				uart_rxbuf_idx = 0;
			}
			return;
		}
		switch(uart_rxbuf_a) {
		case 1:
			if (c == 0x0d) {
				uart_rxbuf1[uart_rxbuf_idx] = 0;
				uart_rxbuf_idx = 0;
				uart_softintrs.bits.uart1_line1 = 1;
				if (uart_softintrs.bits.uart1_line2) {
					/* overflow */
					uart_rxbuf_a = 0;
				} else {
					uart_rxbuf_a = 2;
				}
			} else {
				uart_rxbuf1[uart_rxbuf_idx] = c;
				uart_rxbuf_idx++;
			}
			return;
		case 2:
			if (c == 0x0d) {
				uart_rxbuf2[uart_rxbuf_idx] = 0;
				uart_rxbuf_idx = 0;
				uart_softintrs.bits.uart1_line2 = 1;
				if (uart_softintrs.bits.uart1_line1) {
					/* overflow */
					uart_rxbuf_a = 0;
				} else {
					uart_rxbuf_a = 1;
				}
			} else {
				uart_rxbuf2[uart_rxbuf_idx] = c;
				uart_rxbuf_idx++;
			}
			return;
		default:
			/* overflow condition, wait for next \n */
			uart_rxbuf_idx = UART_RXBUFSIZE;
			(void)c;
		}
	}
}

/* UART2 (rs232) support */
static char uart232_txbuf[UART232_TXBUFSIZE];
static unsigned char uart232_txbuf_prod;
static volatile unsigned char uart232_txbuf_cons;
static char uart232_txsum;

static void
_uart232_putchar (char c)
{
	unsigned char new_uart232_txbuf_prod = (uart232_txbuf_prod + 1) & UART232_TXBUFSIZE_MASK;

again:
        if (new_uart232_txbuf_prod == uart232_txbuf_cons) {
		tx_232_w++;
		while (new_uart232_txbuf_prod == uart232_txbuf_cons) {
			PIE8bits.U2TXIE = 1; /* ensure we'll make progress */
		}
	}
	uart232_txbuf[uart232_txbuf_prod] = c;
	uart232_txbuf_prod = new_uart232_txbuf_prod;
	PIE8bits.U2TXIE = 1;
}

void
uart232_putchar (char c)
{
	if (c == '\n') {
		/* append checksum */
		_uart232_putchar(' ');
		uart232_txsum = (uart232_txsum & 0x3f) + 0x20;
		_uart232_putchar(uart232_txsum);
		_uart232_putchar('\r');
		_uart232_putchar('\n');
		uart232_txsum = 0;
	} else {
		uart232_txsum += c;
		_uart232_putchar(c);
	}
}

void __interrupt(__irq(U2TX), __low_priority, base(IVECT_BASE))
irql_uart2321tx(void)
{
	if (PIE8bits.U2TXIE && PIR8bits.U2TXIF) {
		if (uart232_txbuf_prod == uart232_txbuf_cons) {
			PIE8bits.U2TXIE = 0; /* buffer empty */
		} else {
			/* Place char in TXREG - this starts transmition */
			U2TXB = uart232_txbuf[uart232_txbuf_cons];
			uart232_txbuf_cons = (uart232_txbuf_cons + 1) & UART232_TXBUFSIZE_MASK;
		}
	}
}

char uart232_rxbuf1[UART232_RXBUFSIZE];
char uart232_rxbuf2[UART232_RXBUFSIZE];
unsigned char uart232_rxbuf_idx;
unsigned char uart232_rxbuf_a;
static char uart232_rxsum;

void __interrupt(__irq(U2RX), __low_priority, base(IVECT_BASE))
irql_uart2321rx(void)
{
	if (PIR8bits.U2RXIF) {
		char c;
		__ram char *buf;

		if (U2ERRIRbits.RXFOIF || U2ERRIRbits.FERIF) {
			c = U2RXB;
			(void)c;
			U2ERRIRbits.RXFOIF = 0;
			/* error; ignore line */
			rx_232_cs++;
			uart232_rxbuf_idx = UART232_RXBUFSIZE;
			return;
		}
		c = U2RXB;
		if (U2ERRIRbits.RXBKIF)
			U2ERRIRbits.RXBKIF = 0;
		if (c == 0x0a)
			return;

		if (uart232_rxbuf_idx == UART232_RXBUFSIZE) {
			/* overflow, reset on \n */
			if (c == 0x0d) {
				rx_232_ov++;
				uart232_rxbuf_idx = 0;
				uart232_rxsum = 0;
				if (uart_softintrs.bits.uart232_line1 == 0)
					uart232_rxbuf_a = 1;
				else if (uart_softintrs.bits.uart232_line2 == 0)
					uart232_rxbuf_a = 2;
			}
			return;
		}
		switch(uart232_rxbuf_a) {
		case 1:
			buf = uart232_rxbuf1;
			break;
		case 2:
			buf = uart232_rxbuf2;
			break;
		default:
			/* overflow condition, wait for next \n */
			uart232_rxbuf_idx = UART232_RXBUFSIZE;
			(void)c;
			return;
		}
		if (c == 0x0d) {
			if (uart232_rxbuf_idx < 2) {
				/* not enough chars */
				uart232_rxbuf_idx = 0;
				uart232_rxsum = 0;
				rx_232_cs++;
				return;
			}
			/* finalize checksum */
			uart232_rxsum -= buf[uart232_rxbuf_idx - 1];
			uart232_rxsum -= ' ';
			uart232_rxsum = (uart232_rxsum & 0x3f) + 0x20;
			if (uart232_rxsum != buf[uart232_rxbuf_idx - 1]) {
				/* wrong csum */
				uart232_rxbuf_idx = 0;
				uart232_rxsum = 0;
				rx_232_cs++;
				return;
			}
			buf[uart232_rxbuf_idx - 2] = 0;
			uart232_rxbuf_idx = 0;
			uart232_rxsum = 0;
			if (uart232_rxbuf_a == 2) {
				uart_softintrs.bits.uart232_line2 = 1;
				if (uart_softintrs.bits.uart232_line1) {
					/* overflow */
					uart232_rxbuf_a = 0;
				} else {
					uart232_rxbuf_a = 1;
				}
			} else {
				uart_softintrs.bits.uart232_line1 = 1;
				if (uart_softintrs.bits.uart232_line2) {
					/* overflow */
					uart232_rxbuf_a = 0;
				} else {
					uart232_rxbuf_a = 2;
				}
			}
		} else {
			buf[uart232_rxbuf_idx] = c;
			uart232_rxsum += c;
			uart232_rxbuf_idx++;
		}
		return;
	}
}

void
uart232_init() {
	IPR8bits.U2TXIP=0;
	IPR8bits.U2RXIP=0;
	uart232_txbuf_prod = uart232_txbuf_cons = 0;
	uart232_txsum = uart232_rxsum = 0;
	uart232_rxbuf_idx = 0;
	uart232_rxbuf_a= 1;
	PIE8bits.U2RXIE = 1;
}


/* linky (UART3) support, input only */

char linky_rxbuf1[LINKY_RXBUFSIZE];
char linky_rxbuf2[LINKY_RXBUFSIZE];
unsigned char linky_rxbuf_idx;
unsigned char linky_rxbuf_a;
static char linky_rxsum;

volatile union linky_softintrs linky_softintrs;

void __interrupt(__irq(U3RX), __low_priority, base(IVECT_BASE))
irql_linky1rx(void)
{
	if (PIR9bits.U3RXIF) {
		char c = (U3RXB & 0x7f);
		__ram char *buf;

		if (U3ERRIRbits.RXFOIF || U3ERRIRbits.FERIF) {
			(void)c;
			U3ERRIRbits.RXFOIF = 0;
			/* error; ignore line */
			rx_linky_cs++;
			linky_rxbuf_idx = LINKY_RXBUFSIZE;
			return;
		}
		if (U3ERRIRbits.RXBKIF)
			U3ERRIRbits.RXBKIF = 0;

		if (linky_rxbuf_idx == LINKY_RXBUFSIZE) {
			/* overflow, reset on \r */
			if (c == 0x0d) {
				rx_linky_ov++;
				linky_rxbuf_idx = 0;
				linky_rxsum = 0;
				if (linky_softintrs.bits.linky_line1 == 0)
					linky_rxbuf_a = 1;
				else if (linky_softintrs.bits.linky_line2 == 0)
					linky_rxbuf_a = 2;
			}
			return;
		}
		switch(linky_rxbuf_a) {
		case 1:
			buf = linky_rxbuf1;
			break;
		case 2:
			buf = linky_rxbuf2;
			break;
		default:
			/* overflow condition, wait for next \n */
			linky_rxbuf_idx = LINKY_RXBUFSIZE;
			(void)c;
			return;
		}
		if (c == 0x0a) {
			if (linky_rxbuf_idx < 2) {
				/* not enough chars */
				linky_rxbuf_idx = 0;
				linky_rxsum = 0;
				rx_linky_cs++;
				return;
			}
			/* finalize checksum */
			linky_rxsum -= buf[linky_rxbuf_idx - 1];
			linky_rxsum -= ' ';
			linky_rxsum = (linky_rxsum & 0x3f) + 0x20;
			if (linky_rxsum != buf[linky_rxbuf_idx - 1]) {
#if 0
				/* wrong csum */
				linky_rxbuf_idx = 0;
				linky_rxsum = 0;
				rx_linky_cs++;
				return;
#else
				if (linky_rxbuf_a == 2)
					linky_softintrs.bits.linky_badcs_l2 = 1;
				else
					linky_softintrs.bits.linky_badcs_l1 = 1;
				buf[linky_rxbuf_idx] = 0;
			} else
#endif
				buf[linky_rxbuf_idx - 2] = 0;
			linky_rxbuf_idx = 0;
			linky_rxsum = 0;
			if (linky_rxbuf_a == 2) {
				linky_softintrs.bits.linky_line2 = 1;
				if (linky_softintrs.bits.linky_line1) {
					/* overflow */
					linky_rxbuf_a = 0;
				} else {
					linky_rxbuf_a = 1;
				}
			} else {
				linky_softintrs.bits.linky_line1 = 1;
				if (linky_softintrs.bits.linky_line2) {
					/* overflow */
					linky_rxbuf_a = 0;
				} else {
					linky_rxbuf_a = 2;
				}
			}
		} else if (c == 0x02) {
			linky_softintrs.bits.linky_sof = 1;
		} else if (c == 0x03 || c == 0x04) {
			linky_softintrs.bits.linky_eof = 1;
		} else if (c >= 32) {
			buf[linky_rxbuf_idx] = c;
			linky_rxsum += c;
			linky_rxbuf_idx++;
		} else {
			(void)c;
		}
		return;
	}
}

void
linky_init() {
	linky_softintrs.byte = 0;
	IPR9bits.U3TXIP=0;
	IPR9bits.U3RXIP=0;
	linky_rxsum = 0;
	linky_rxbuf_idx = 0;
	linky_rxbuf_a= 1;
	PIE9bits.U3RXIE = 1;
}
