mbouyer/domotique/(commit log)

2024-11-22 version préliminaire des cartes electronique
    [1597DIN6MDH53.dxf, energie.kicad_pcb, energie.kicad_sch, outputs.kicad_sch, ventil.kicad_pcb, ventil.kicad_sch, vmc.kicad_pcb, vmc.kicad_sch]
2024-11-22 vnc: Remplace le driver DRV8832DGQR (obsolete) par un MAX22201
    [vmc.kicad_pcb, vmc.kicad_sch]
2024-11-22 vmc: swap button/LED pins to limit damage on accidental connect to LIN bus. Name remaining connector signals
    [vmc.kicad_pcb, vmc.kicad_sch]
2024-11-24 energie: ajout d'une alimentation AC/DC pour que le module soit autonome (et que la connection à la centrale puisse être isolée)
    [energie.kicad_pcb, energie.kicad_sch]
2024-11-24 Utilise des emprumtes CMS pour deux connecteurs optionels.
    [energie.kicad_pcb, energie.kicad_sch]
2024-11-25 Alimente le driver max22201 en 12V; le courant moteur est limité par le driver en PWM et cela permet de tirer un peu moins sur l'alim (et le régulateur 5V)
    [vmc.kicad_pcb, vmc.kicad_sch]
2024-11-25 Remplace le MCP6006 par MCP6007 que l'on a en stock
    [energie.kicad_pcb, energie.kicad_sch, outputs.kicad_sch]
2024-11-25 Remplace BZB984-C2V4 (non dispo) par BZB84-B2V7
    [energie.kicad_pcb, energie.kicad_sch]
2024-11-25 Energie: mesure de courant ajout d'une resistance de protection serie sur les entrees pic18
    [energie.kicad_pcb, energie.kicad_sch]
2024-11-25 Ajout d'un adapteur rs232/ttl isolé
    [rsr232-iso.kicad_pcb, rsr232-iso.kicad_sch]
2024-11-25 Better clearance for mounting hole precise position for connectors
    [rsr232-iso.kicad_pcb]
2024-11-28 Premier jet d'une carte d'interface avec une olimex A20-lime2.
    [controle.kicad_pcb, controle.kicad_sch, lin.kicad_sch, pic18.kicad_sch, power.kicad_sch]
2024-11-29 Use a 2DIB1411F isolator instead of 2 optocouplers
    [rsr232-iso.kicad_pcb, rsr232-iso.kicad_sch]
2024-11-29 Correct isolator reference
    [rsr232-iso.kicad_sch]
2024-11-29 Cleanup PCB
    [rsr232-iso.kicad_pcb]
2024-12-04 Adjust some references and availability
    [controle.kicad_sch, energie.kicad_sch, outputs.kicad_sch, power.kicad_sch]
2024-12-05 Une petite carte pour tester l'interface linky/serie
    [linky-serial.kicad_pcb, linky-serial.kicad_sch]
2024-12-06 Fix transistor cabling (duh !)
    [linky-serial.kicad_pcb, linky-serial.kicad_sch]
2024-12-06 Fix Q2 wiring, it was reversed Fix U5 footprint Fix C10 and similar footprints
    [energie.kicad_pcb, energie.kicad_sch, outputs.kicad_sch]
2024-12-09 energie: paramètre création gerber
    [energie.kicad_pcb]
2024-12-10 linky interface: update gate resitor value after tests
    [energie.kicad_pcb, energie.kicad_sch, linky-serial.kicad_pcb, linky-serial.kicad_sch]
2024-12-10 energie: update PCB size to match casing
    [energie.kicad_pcb]
2024-12-10 energie: ajout de zones interdites pour les supoort PCB du boitier.
    [energie.kicad_pcb]
2024-12-12 energie, rsr232-iso: ajout des fichiers de fabrication
    [energie-B_Cu.gbr, energie-B_Mask.gbr, energie-Edge_Cuts.gbr, energie-F_Cu.gbr, energie-F_Mask.gbr, energie-PTH.drl, rsr232-iso-Edge_Cuts.gbr, rsr232-iso-F_Cu.gbr]
2024-12-16 software: Squelette pour le logiciel de la carte energie
2024-12-18 energie: name rs232_RX/TX
    [energie.kicad_pcb, energie.kicad_sch]
2024-12-18 Implement buffer input from debug UART
2024-12-18 Use UART2 for rs232
2024-12-19 Implement uart output selection. Dynamically detect when debug UART is available, dynamically turn off when disconnected.
2024-12-19 If uart2's RXBKIF is set, clear it, just in case
2024-12-20 Work in progress on DMA for outputs
2025-01-15 Optimise oututs by switching TRIS between O1 and O2 only. Implement commands to switch outputs
2025-01-16 Add a function to print outputs status
2025-01-16 Implement linky UART reading
2025-01-17 Fix checksum algo to match linky
    [serial.c]
2025-01-18 Tentative de fiabilisation de la liaison linky
2025-01-19 WIP on current measures
2025-01-20 Save a bit more time on outputs; retart DMA as soon as we updated TRISC
2025-01-21 Fix overflow or framing error logic, can't read fifo before testing
    [serial.c]
2025-01-21 Split debug_present and debug_enabled; avoid blindly re-enabling debug output while the UART is disabled
    [main.c]
2025-01-21 If debug UART is not connected at boot, disable it.
2025-01-21 Sample all intensity channels
2025-01-21 Make sure to start ADC. Output currents on rs232 too.
2025-01-22 Ajoute la relation entre I moyen et Irms
2025-01-23 Add a client/server tool to get data from, and send commands to the energy board. The hub connects to the serial port, get commands from client for the boards and relays messages from board to clients
2025-01-23 hub: flock() the tty device
2025-01-23 Traque les débuts et fin de trames du linky, avec timeout. Envoie les données d'intensité pendant l'intertrame, une toute les 100ms.
2025-01-23 Energie: envoie toute les 10s une trame EE avec l'état des sorties.
2025-01-23 hub: Deplace la socket dans /var/run
2025-01-23 Bump UART232_TXBUFSIZE to 128, we want to send more data without blocking
2025-01-23 Back to printing all intensities at once, we don't have that much time in interframe. factor out interframe prints in one function, and call it as soon as we see end of frame. Check SOF before linky 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
2025-01-23 Use proper printf format for time_t
2025-01-23 energie: send a frame tag as first character, changed on every EOF or frame timeout. energie-hub: use the frame tag to timestamp a complete message
2025-01-23 Permet différents rythmes pour la LED. 1 court si communication depuis linky, 2 plus long si timeout.
2025-01-23 Deplace le gros des calculs pour int_100hz dans irqh_timer2, la boucle peut parfois prendre plus de 10ms.
2025-01-23 Split print_interframe() in smaller tasks called from the main loop
2025-01-23 for outputs, restart DMA only if we really updated TRISC
2025-01-23 Après correstion du bug sur les interruptions DMA1 on peut de nouveau utiliser %d au lieu de %x pour les intensités
    [main.c]
2025-01-24 Keep indexes to track energy
2025-01-24 Print indexes as part of status
2025-01-24 Fix units in comments
    [main.c]
2025-01-24 Tentative de correction du bruit
    [main.c]
2025-01-24 Give twice the time to power outputs.
2025-01-25 Bump rs232 tx buf size to 256; avoids busy waits
    [serial.h]
2025-02-05 Utilise un nombre premier pour le diviseur timer4, pour éviter une lente oscillation entre 50Hz et les sorties
    [main.c]
2025-02-06 Ajout d'un hub+client pour les capteurs. Gère uniquement un bme280 local pour le moment
2025-03-21 vmc: adjust motor position
    [vmc.kicad_pcb]
2025-03-21 ventil: route PCB
    [ventil.kicad_pcb, ventil.kicad_sch]
2025-03-21 vmc: update ICSP connector to match ventil
    [vmc.kicad_pcb, vmc.kicad_sch]
2025-03-23 ventil, vmc: switch 7805 to a less expensive package
    [ventil.kicad_pcb, ventil.kicad_sch, vmc.kicad_pcb, vmc.kicad_sch]
2025-03-23 ventil/CAD: start of design
    [reglage.dxf]
2025-03-24 ventil: WIP on trap model
    [reglage.dxf]
2025-03-30 hardware/vmc: convert a via to testpoint, so we can have a true PTH
    [vmc.kicad_pcb, vmc.kicad_sch]
2025-03-30 hardware/vmc: generate fab files
    [vmc.kicad_pcb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]
2025-03-30 hardware/controle: fix sort circuit on RS232 interface
    [controle.kicad_sch]
2025-03-31 Generate fabrication files
    [ventil.kicad_pcb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]
2025-04-10 software/ventil: motor open/close
2025-04-10 software/ventil: manage motor from lin
2025-04-10 hardware/ventil: minor cleanup
    [ventil.kicad_sch]
2025-04-10 hardware/ventil/CAD/reglage.dxf: ajout de la seconde bielle; ajout de cotes
    [reglage.dxf]
2025-04-11 Ajout du support pour les trappes
    [reglage.dxf, support-trappe.scad]
2025-04-11 Ajout du support moteur
    [passage_bielles.dxf, reglage.dxf, support-moteur.scad]
2025-04-11 ventil: supports: ajout de pions de centrage
    [reglage.dxf, support-moteur.scad, support-trappe.scad]
2025-04-11 support-trappe.scad: ajout passage pour vis cache
    [support-trappe.scad]
2025-04-14 hardware: ajout support pour le capteur SEN0385
    [support-SEN0385.scad, support-SEN0385.stl]
2025-04-14 hardware/ventil/CAD: Ajout des axes
    [axes.scad, axes_tete.scad]
2025-04-15 Ajout dessin levier moteur (avec corrections pour découpe laser)
    [levier.dxf]
2025-04-15 hardware/ventil/CAD: ajout DXF du gabari
    [gabari.dxf]
2025-04-15 hardware/ventil/CAD: ajout du gabari dans le dessin general
    [reglage.dxf]
2025-04-15 hardware/ventil/CAD: ajout DXF trappes et bielles
    [bielles.dxf, reglage.dxf, trappes.dxf]
2025-04-15 support-SEN0385: renforce la liaison entre cloison et autres éléments
    [support-SEN0385.scad]
2025-04-15 support-SEN0385: Minor adjusts, regen stl
    [support-SEN0385.scad, support-SEN0385.stl]
2025-04-16 software/ventil: adjust step count for full open reset to close state at startup
    [main.c]
2025-04-16 Ruby veut un seul objet par fichier dxf, sinon les dimensions ne sont pas bonnes ...
    [bielle-1.dxf, bielle-2.dxf]
2025-04-16 hardware/ventil/CAD: supports: MAJ pour plexi 6mm et autre ajustements mineurs.
    [support-moteur.scad, support-trappe.scad]
2025-04-16 ventil: support-moteur & gabari: Ajout passages pour vis existantes
    [gabari.dxf, reglage.dxf, support-trappe.scad, trappes.dxf]
2025-04-17 hardware/fab: elargi un peu le masque soudure du SHT31; regenere et inverse la couche f_paste (pour que le coté laser soit au contact du PCB)
    [vmc.kicad_pcb]
2025-04-18 hardware/ventil: name SCL/SDA
    [ventil.kicad_pcb, ventil.kicad_sch]
2025-04-18 - separate status and action on LIN - add a reset action - add a broadcast LIN id (0x3c)
    [main.c, serial.c]
2025-04-18 ventil/support-moteur: ajoute du jeu au niveau du plexi pour prendre le compte le jeu axial du moteur
    [support-moteur.scad]
2025-05-09 Add a breakout board for sht31
    [sht31-break.kicad_pcb, sht31-break.kicad_sch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]
2025-05-13 support-trappe: remplace l'axe de la trappe par un trou; l'axe sera rapporté et maintenu par vis.
    [support-trappe.scad]
2025-05-16 Fix motor outputs generation
    [main.c]
2025-05-23 blink LED if I2C fails
    [main.c]
2025-05-23 ventil: bring LED handling in line with vmc
2025-05-23 ventil, vmc: clear STATUS_VALID is i2c fails
    [main.c]
2025-10-03 Add a box 3d design for the dfrobot SEN0331 SHT31 board. The 2 parts are assembled with 2 2x7mm screws
    [base.scad, base.stl, board.dxf, box.scad, box.stl, params.scad, roundedcube.scad]
2026-01-08 controle: add P-MOS transistors to control power to the LIN devices
    [controle.kicad_sch, lin.kicad_sch]
2026-01-09 controle: - pass ERC - adjust some components and connections - place components on board
    [controle.kicad_pcb, controle.kicad_sch, pic18.kicad_sch, power.kicad_sch]
2026-01-09 Controle: route board
    [controle.kicad_pcb]
2026-01-09 Update LED resistors values. Minor updates to PCB
    [controle.kicad_pcb, controle.kicad_sch]
2026-01-09 controle: minor board update
    [controle.kicad_pcb]
2026-01-09 controle: - add leds for LIN power - add optional led for LIN activity - fix lime2 mounting holes - other misc cleanups
    [controle.kicad_pcb, lin.kicad_sch]
2026-01-10 controle: fix orioentation of rs232 module connector
    [controle.kicad_pcb, lin.kicad_sch]
2026-01-20 controle: update 40pins connector footprint
    [controle.kicad_pcb]
2026-01-20 controle: update for DRC
    [controle.kicad_pcb]
2026-03-22 hardware/controle: adjust RGB leds resistors
    [controle.kicad_pcb, controle.kicad_sch]
2026-04-17 hardware/controle: add fiducials (for OpenPnP)
    [controle.kicad_pcb, controle.kicad_sch]
2026-04-29 hardware/controle: re-route so that most connectors are on left and right sides, same as the lime2 board
    [controle.kicad_pcb]
2026-06-02 hardware/controle: minor PCB adjustements
    [controle.kicad_pcb]
2026-06-02 hardware/controle: control CPU power from pic18: - add a separate 3.3V power for pic18 - use the pic18 to start the tps54228
    [controle.kicad_sch, lin.kicad_sch, pic18.kicad_sch, power.kicad_sch]
2026-06-02 hardware/controle: route control CPU power from pic18
    [controle.kicad_pcb, controle.kicad_sch, lin.kicad_sch, pic18.kicad_sch, power.kicad_sch]
2026-06-02 hardware/controle: generate fab files
    [controle.kicad_pcb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]
2026-06-08 hardware/controle: update some component values and P/N
    [controle.kicad_pcb, controle.kicad_sch, lin.kicad_sch, pic18.kicad_sch, power.kicad_sch]
2026-06-08 hardware/controle: add solder paste files
2026-06-08 controle/hardware: fix grid/drill origin, for lumenPnP
    [controle.kicad_pcb]
2026-06-09 hardware/controle: fix LED value
    [power.kicad_sch]
2026-06-09 hardware/controle: update P/N fields
    [controle.kicad_pcb, lin.kicad_sch, pic18.kicad_sch, power.kicad_sch]
2026-06-11 rdware/controle: move back some resistors to 47k to match our stock
    [controle.kicad_pcb, lin.kicad_sch, power.kicad_sch]
2026-06-11 hardware/controle: update P/N of 100nF capacitors
    [controle.kicad_pcb, controle.kicad_sch, pic18.kicad_sch, power.kicad_sch]
2026-06-13 software/controle: initial support for board hardware/controle
2026-06-15 software/controle/firmware: minimal I2c client setup; responds to a scan
2026-06-16 hardware/CAD: add design to hold the controle+lime2 boards, +HDD
    [support-controle.FCStd, support-controle.dxf]
2026-06-18 software/controle/firmware: basic i2c client support
2026-06-18 software/controle/firmware: implement VCPU timer logic On reset, check if it's a power on or brown-out reset. If so, turn off VCPU and arm power on timer. If not, make sure VCPU is on.
    If the timer_cpu_off expires, turn off VCPU and arm the power on timer.
    [main.c]
2026-06-18 software/controle/firmware: improve i2c support: - add an API version, reported in register 0 - support register writes - implement CPU power cycle on magic number writes
2026-06-18 software/controle/firmware: clear I2C buffers on NACK
2026-06-19 capteurs-hub: sending BREAK on line using hardware break is unreliable and cause corruption on the RX side (and I suspect also on the client side). Send a 0x00 at low speed instead. With this no erro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
    [capteurs-hub.c]
2026-06-21 capteur-hub: don't report any value if bme280_get_sensor_data() fails. While there convert some warn() or perror() to mylog()
    [capteurs-hub.c]
2026-06-23 capteurs-hub: report value from the controle board light sensor
2026-09-08 energie/serial.c: fix error recovery
    [serial.c]
2026-09-14 software/scheduler: WIP on a command sheduler
    it takes a config file as input, one line per schedule.
    Each line specifies a start and end date/time (in cron format) and an action
    in perl syntax. The action can use extra conditions from perl variables
    (like %state), allowing to define actions based on both time intervals and
    capteurs or energy states. Each action returns an hash of desired output state.
    Actions are executed in order, so an action output can overwrite a previous
    one.
    TODO: allow overrides from the scheduler socket
2026-09-16 scheduler: cleanup socket error path
    If there is an error on capteur or energie sockets, make sure to close
    all sockets before sleeping. We should not keep a socket open without reading
    it.
2026-09-16 scheduler: undef $socket after closing it; so that it properly reconnects
2026-09-27 software/scheduler/display.pl: un programme qui pilote les leds RGB en fonction de la couleur du tarif
2026-10-04 software/automation: add schedule override
    add support for commands overrides to scheduler.pl via unix socket.
    An overrides is a command with start and end time (in unix time()). When
    the current date is past the end time the override is removed from the
    list.
    Add schedule.pl, a script to send overrides to the scheduler.
